TriEmbed/quercus/hardware/breakouts/README.md

# que_breakouts
Quercus project breakout board design files
## SLG46826G breakout for the TSOP-20 package part
