TriEmbed/quercus/hardware/white/esp32pinout.odt

CLK SDD CONN SD3 CMD

SD1 TDO TCK SD2

IO2 VCC 3.3V NC

IO0 GND IO5 TMS

IO4 IO16 IO23 IO34

TDI IO17 IO19 IO33

IO32 IO21 IO18 IO35

IO25 IO22 IO26 SVN

IO27 RXD SVP NC

GND TXD RST GND

CLK SDD CONN SD3 CMD

SD1 TDO TCK SD2

IO2 VCC 3.3V NC

IO0 GND IO5 TMS

IO4 IO16 IO23 IO34

TDI IO17 IO19 IO33

IO32 IO21 IO18 IO35

IO25 IO22 IO26 SVN

IO27 RXD SVP NC

GND TXD RST GND

CLK SDD CONN SD3 CMD

SD1 TDO TCK SD2

IO2 VCC 3.3V NC

IO0 GND IO5 TMS

IO4 IO16 IO23 IO34

TDI IO17 IO19 IO33

IO32 IO21 IO18 IO35

IO25 IO22 IO26 SVN

IO27 RXD SVP NC

GND TXD RST GND

CLK SDD CONN SD3 CMD

SD1 TDO TCK SD2

IO2 VCC 3.3V NC

IO0 GND IO5 TMS

IO4 IO16 IO23 IO34

TDI IO17 IO19 IO33

IO32 IO21 IO18 IO35

IO25 IO22 IO26 SVN

IO27 RXD SVP NC

GND TXD RST GND
