TriEmbed/quercus/doc/hardware/wemos/images/20220123-wemos-wrover-bottom-legend.jpg

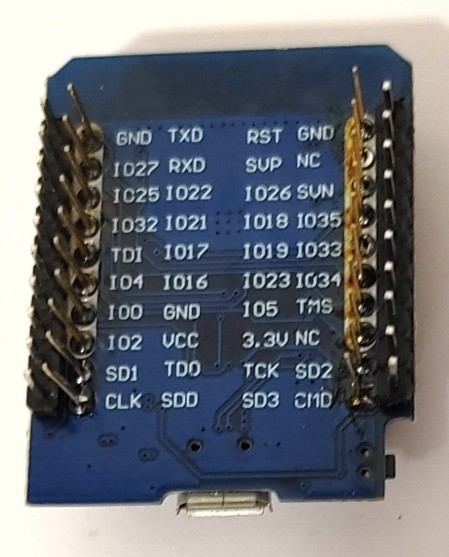
doc/hardware/wemos/images/20220123-wemos-wrover-bottom-legend.jpg
