TriEmbed/quercus/doc/hardware/wemos/images/20220123-wemos-wrover-bottom-view.jpg

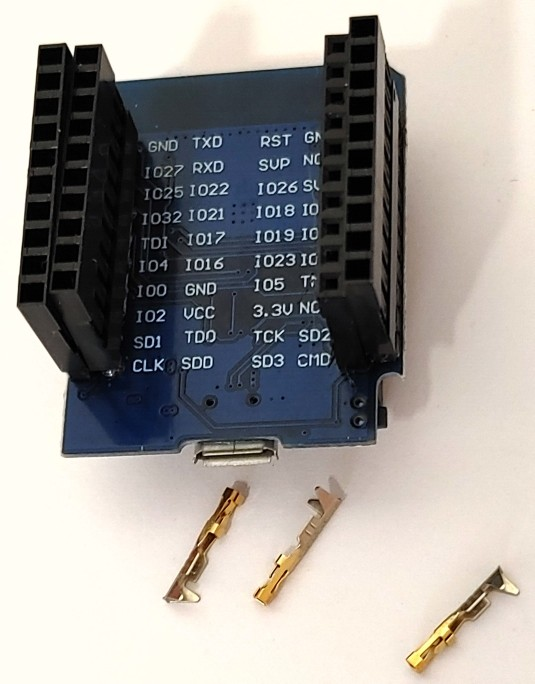
doc/hardware/wemos/images/20220123-wemos-wrover-bottom-view.jpg
