TriEmbed/quercus/doc/hardware/wemos/images/20220123-wemos-wrover-top-view.jpg

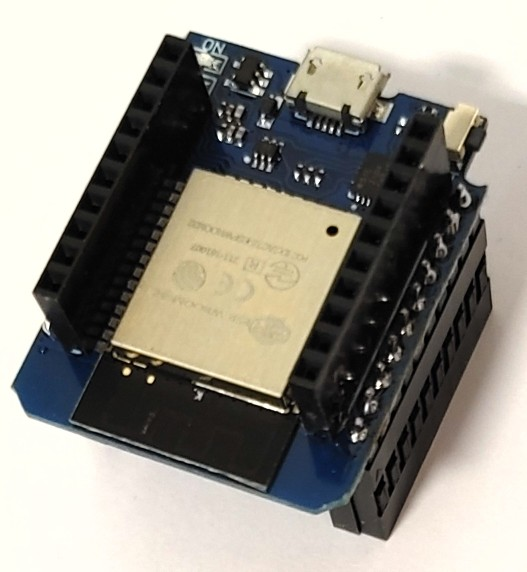
doc/hardware/wemos/images/20220123-wemos-wrover-top-view.jpg
