TriEmbed/quercus/hardware/breakouts/SLG46826G-bottom.png

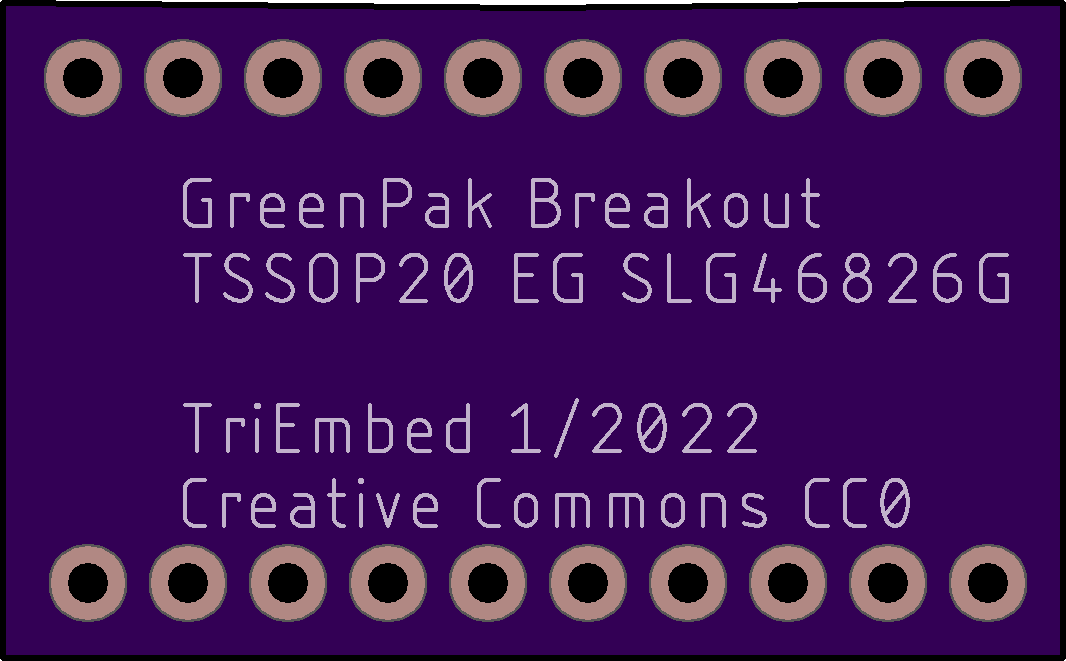
hardware/breakouts/SLG46826G-bottom.png
