TriEmbed/quercus/hardware/breakouts/SLG46826G-top.png

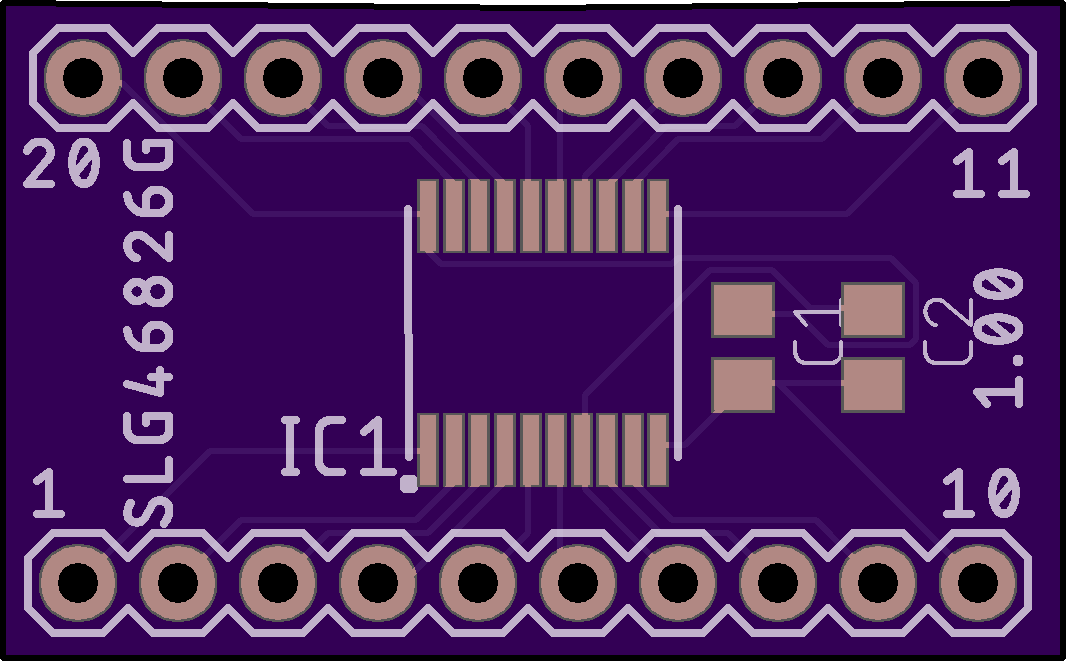
hardware/breakouts/SLG46826G-top.png
