TriEmbed/quercus/hardware/green/images/que-firedeck.jpg

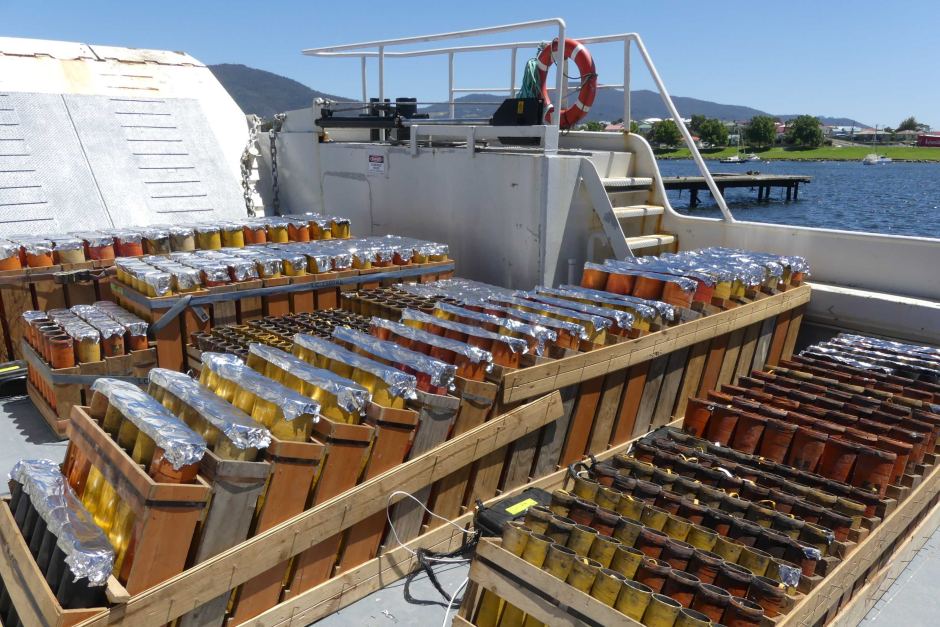
hardware/green/images/que-firedeck.jpg
