TriEmbed/quercus/hardware/purple/images/m80.png

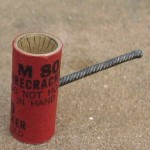
hardware/purple/images/m80.png
