TriEmbed/quercus/hardware/purple/images/model-esp32-board.jpg

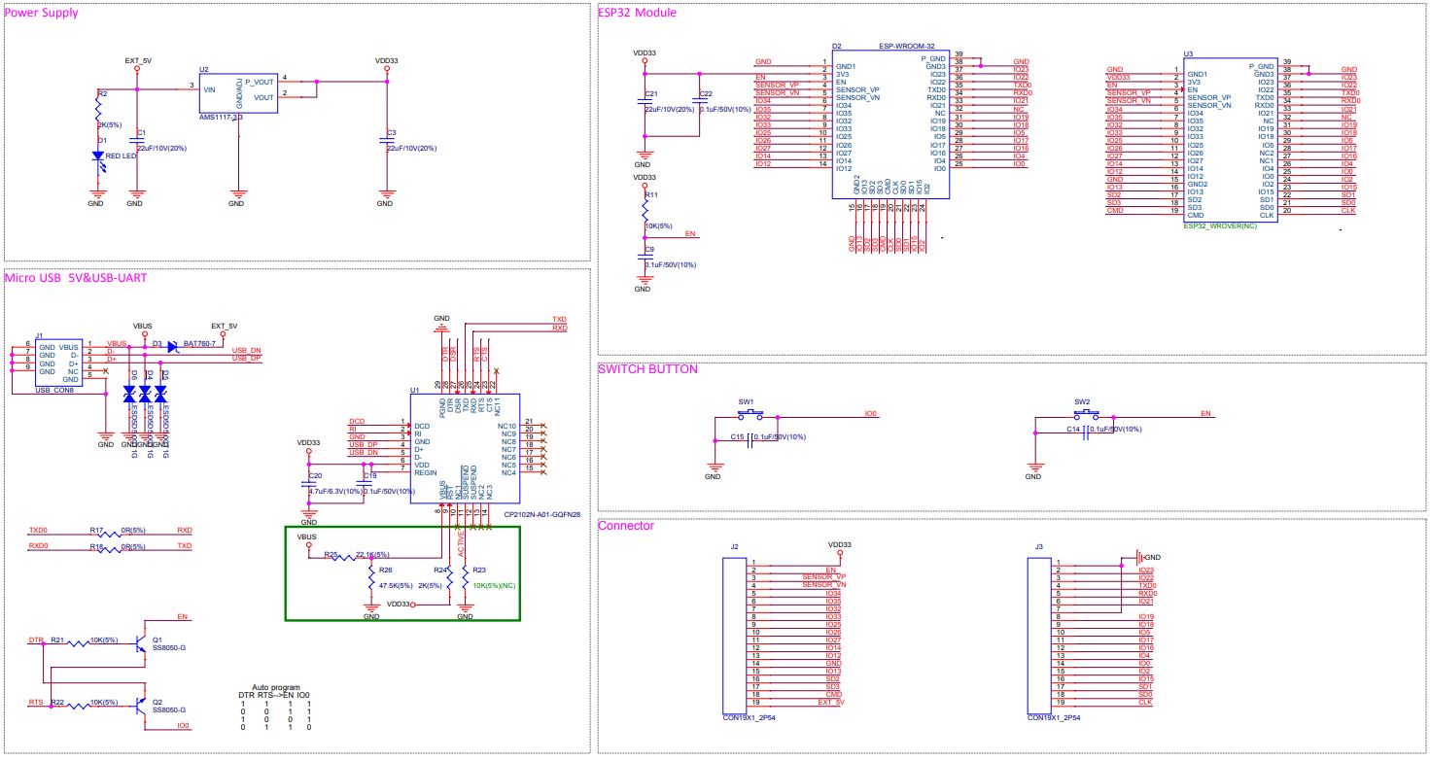
hardware/purple/images/model-esp32-board.jpg
