TriEmbed/quercus/hardware/white/board-top-view.jpg

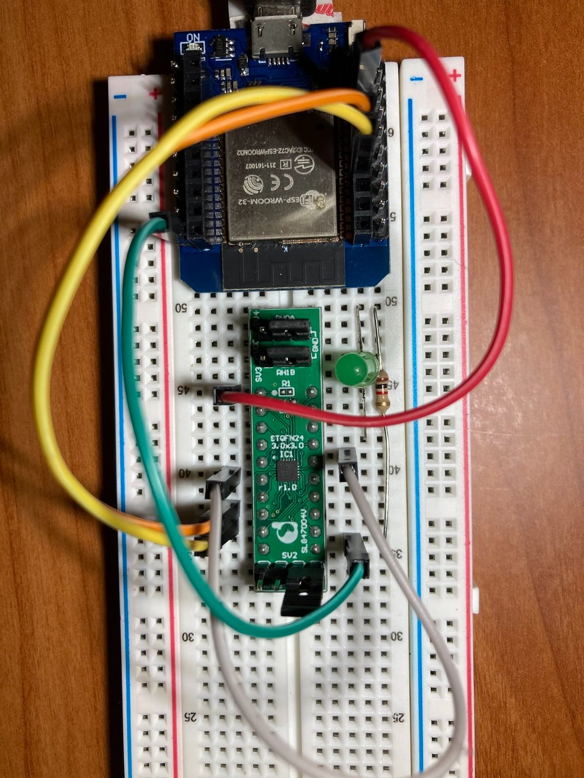
hardware/white/board-top-view.jpg
