TriEmbed/quercus/tools/aardvark-screens/image0.png

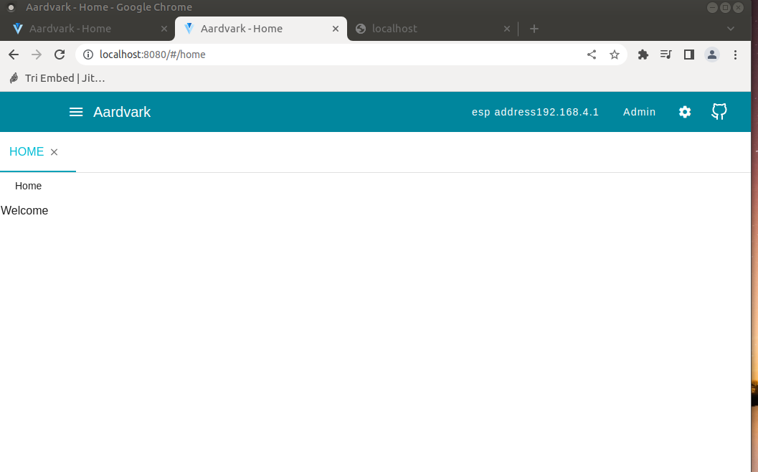
tools/aardvark-screens/image0.png
