TriEmbed/quercus/tools/aardvark-screens/image1.png

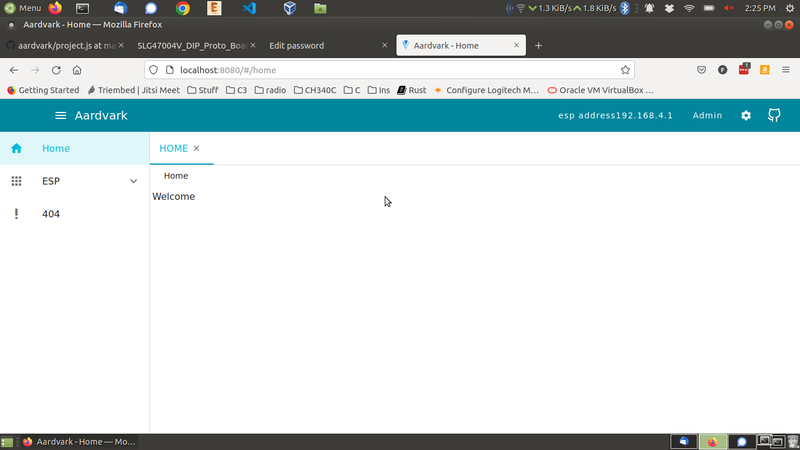
tools/aardvark-screens/image1.png
