TriEmbed/quercus/tools/aardvark-screens/image2.png

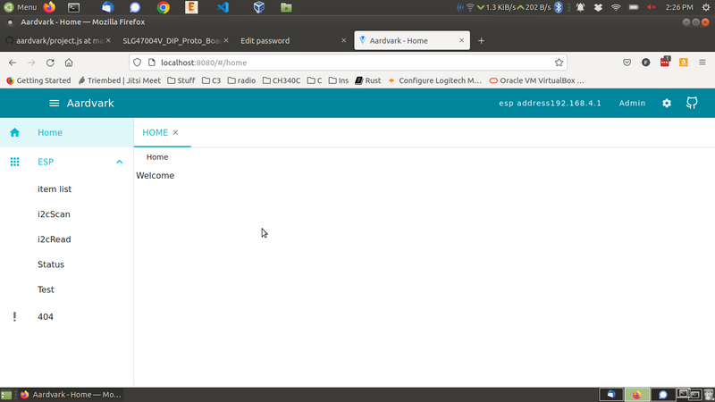
tools/aardvark-screens/image2.png
