TriEmbed/quercus/tools/aardvark-screens/image3.png

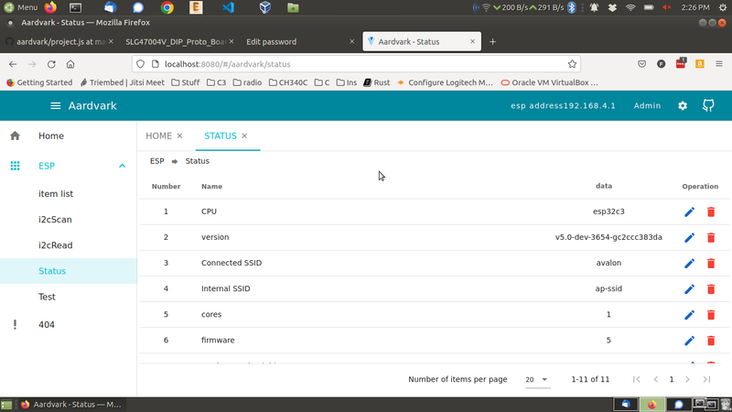
tools/aardvark-screens/image3.png
