TriEmbed/quercus/tools/aardvark-screens/image4.png

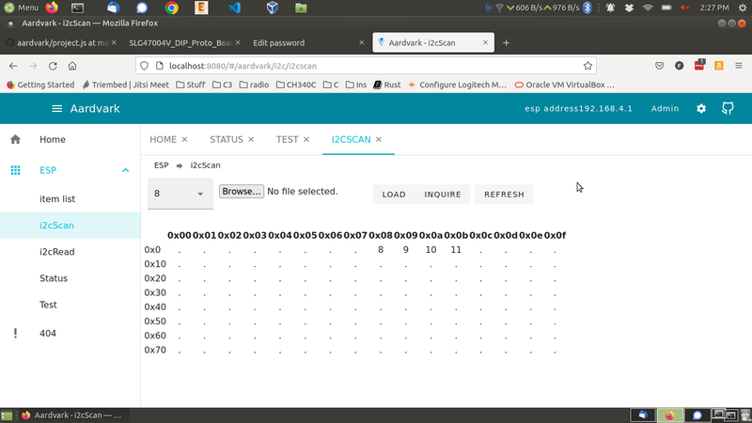
tools/aardvark-screens/image4.png
