TriEmbed/quercus/tools/aardvark-screens/image5.png

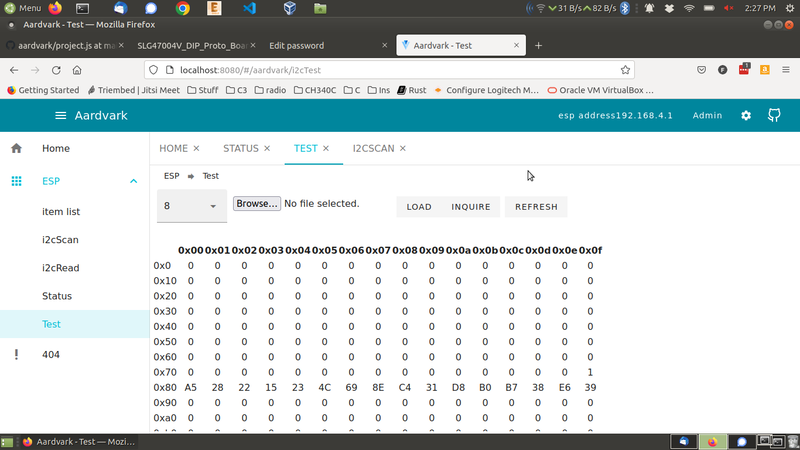
tools/aardvark-screens/image5.png
