TriEmbed/quercus/hardware/purple/doc/INVENTORY.md

# TriEmbed Community Project Material Inventory

## @ Edgington Labs (Nick Edgington)
1. 100 OTP Dialog chips + one special SMD programming socket
2. ESP32 and ESP C3 modules, breakouts, related resources
3. 2 SLG47004V-DIP breakouts
4. 2 SLG46826G breakouts
5. 10 LM1117 3.3 v regulator chips
6. N MINI USB sockets for prototype board
7. One version 0.70 m80 board
    1. 4.7uF cap from EN to ground to stretch resets
    2. Pullup/SPST combos on EN, GPIO8 and GPIO9 to set boot state
8. Several "plexiglas ESP32C3 module carrier boards"

## @ Apex Proto Factory (Pete Soper)
1. One version 0.60 m80 board
2. One version 0.70 m80 board
3. 6 SLG46826G chips
4. 10 SLG46824G chips
5. 10 SLG46620G chips
6. 17 SLG47004V-DIP breakouts
7. Approx 40 SLG47004V-DIP breakouts
8. 15 TSSOP20/SOIC20 Adafruit breakout boards for above 3 TSSOP package chips
9. ESP32 related resources
11. 12 LM1117 3.3 v regulator chips
12. 43 mini USB sockets suitable for SMT
13. 15 ES32C3 modules

## @ Paul MacDougal
1. More USB mini sockets to barter for stuff

## @ Jaimie Johnsen
1. One version 0.70 m80 board
2. One SLG47004V-DIP

## @ Rob Mackie
1. One 0.60 m80 board
2. One SLG47004V-DIP
