TriEmbed/quercus/hardware/purple/eagle/v0.70/BOM.ods

MF Part #` | Vendor # | Vendor | Description | quantity
USB2066-05-RBHM-15-STB-00-00-A | 640-2665RBHM15STB00A | Mouser | Mini USB socket | 1
CH340C |  | Ebay | USB interface chip with RTS, DTR control | 1
LM1117MPX-3.3/NOPB | LM1117MPX-3.3/NOPBCT-ND | Digikey | 3.3V, 800mA linear regulator SOT223-4 package | 1
 |  | Pete | 0805 10uF ceramic capacitor | 1
 |  | Pete | 0805 4.7uF ceramic capacitor | 1
 |  | Pete | 0805 510 ohm resistor | 2
 |  | Pete | 0805 yellow LED | 1
 |  | Pete | 0805 blue LED | 1
 |  | Digikey | 100uF aluminum electrolytic capacitor | 1
ESP32-C3-M01 |  | Ebay | AI Thinker ESP32-C3-M1 module 4MB flash | 1
TS09-63-25-R-160-SMT-TR | 179-TS09625R160SMTTR | Mouser | SPST momentary contact switch – red | 1
TS09-63-25-WT-160-SMT-TR | 179-TS0925WT160SMTTR | Mouser | SPST momentary contact switch – white | 1
JS202011SCQN | 611-JS202011SCQN | Mouser | SPDT slide switch | 1
 |  | Pete | nine position right angle male header | 2
 |  | Pete | 10 position long pin female header | 4
 |  | Pete | four position right angle male header | 1
Last updated 7/22/2022
