TriEmbed/quercus/doc/presentations/20220831-InstallSteps.odp

## Quercus Installation/startup in pictures 8/31/2022

The following slides show a shell session during the build, install and startup steps for the Quercus software and firmware and the browser view of the Aardvark software running.

## Slide 2

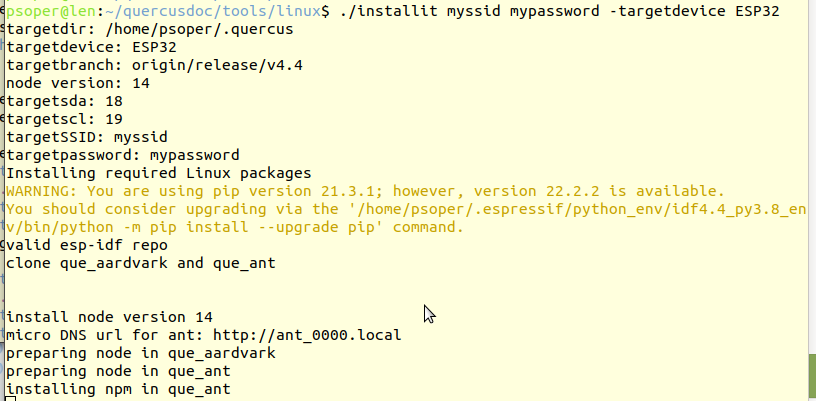
[picture p21: figure]

## Slide 3

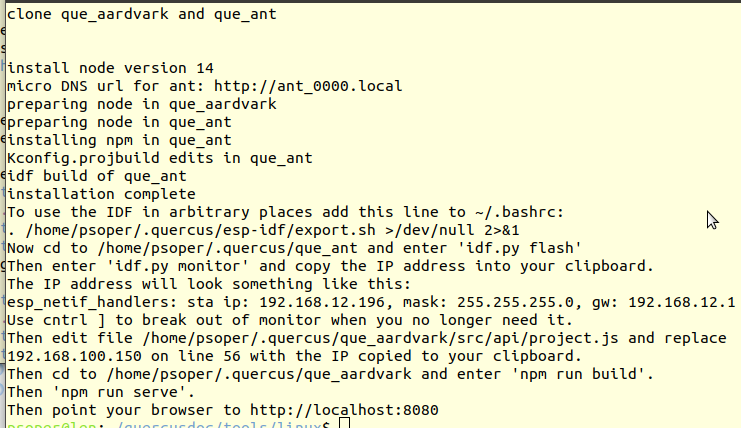
[picture p22: figure]

## Slide 4

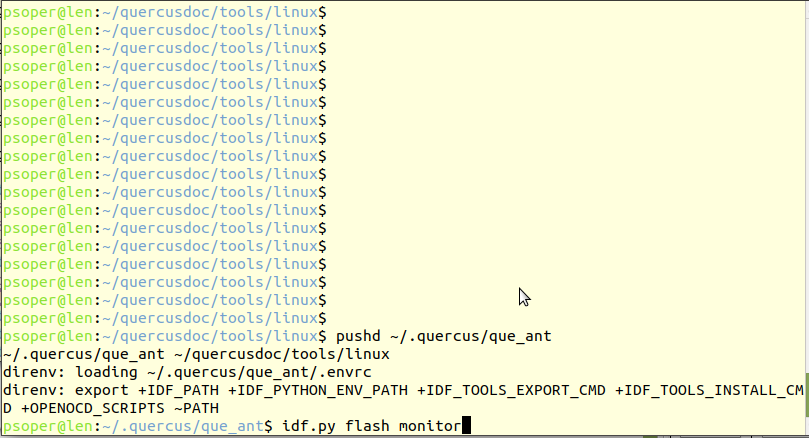
[picture p23: figure]

## Slide 5

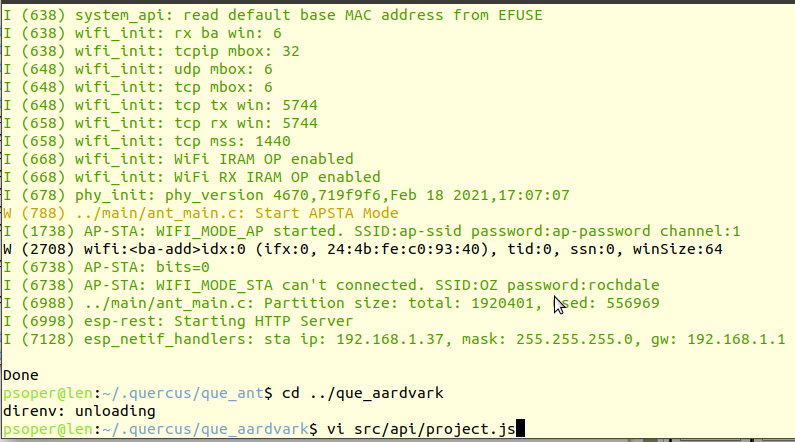
[picture p24: figure]

## Slide 6

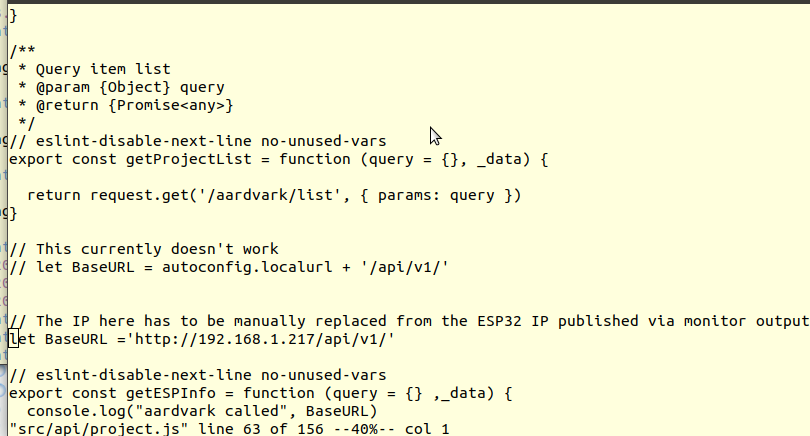
[picture p25: figure]

## Slide 7

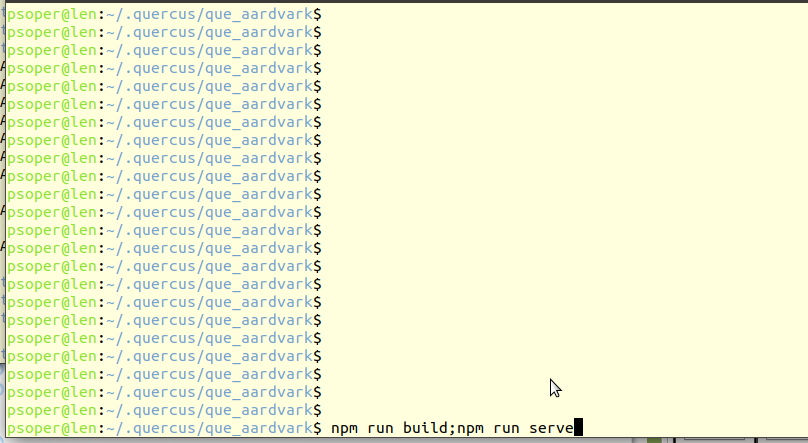
[picture p26: figure]

## Slide 8

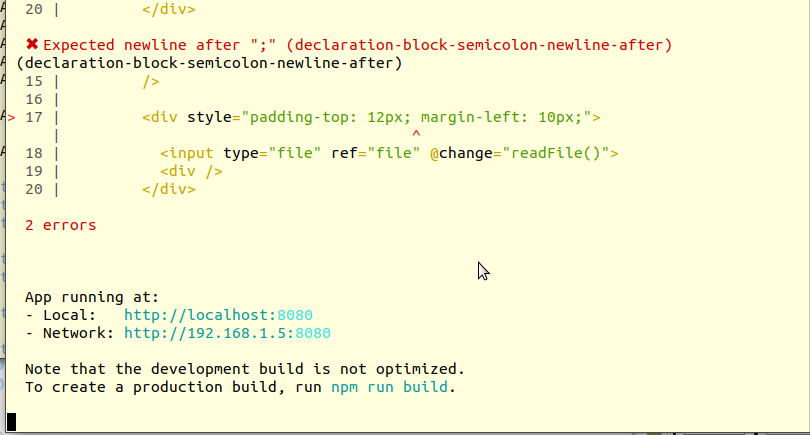
[picture p27: figure]

## Slide 9

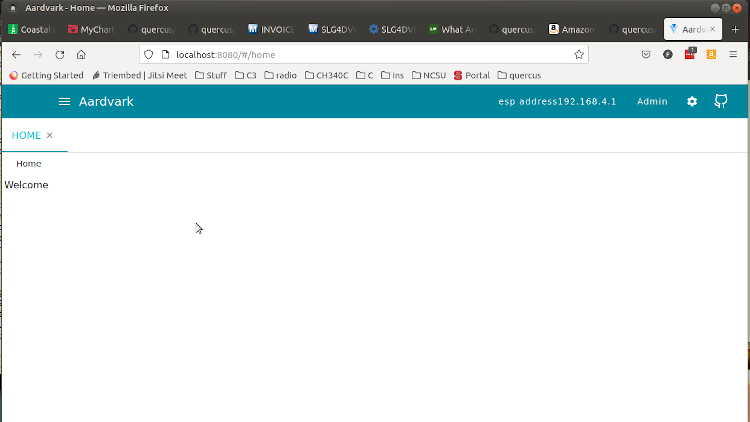
[picture p28: figure]

## Slide 10

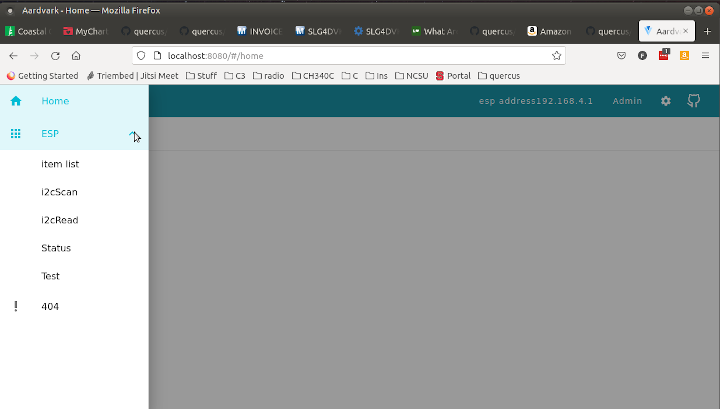
[picture p29: figure]

## Slide 11

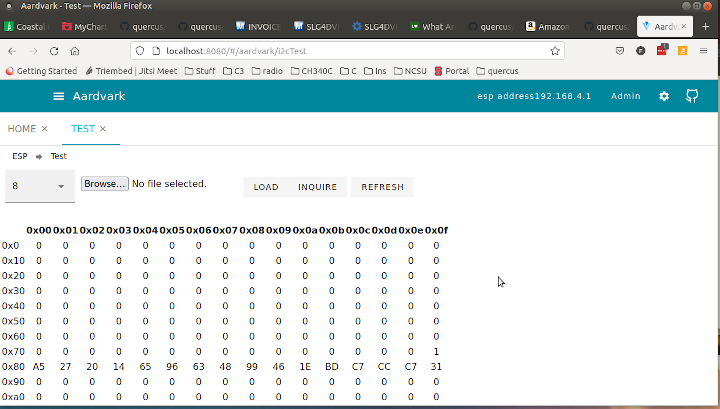
[picture p30: figure]

## Slide 12

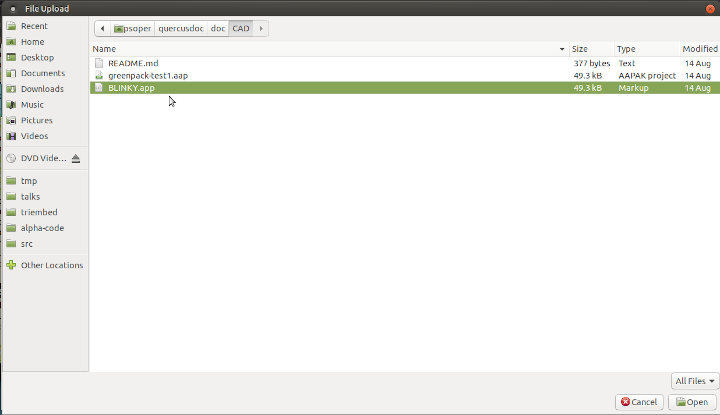
[picture p31: figure]

## Slide 13

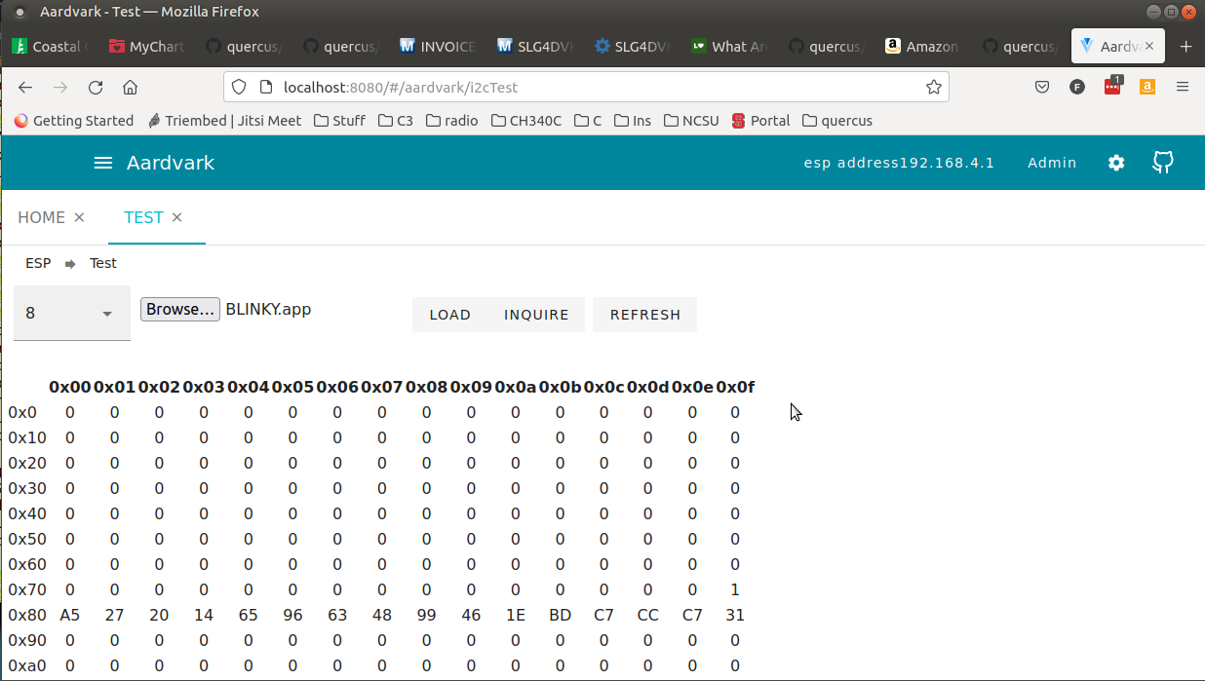
[picture p32: figure]
