TriEmbed/quercus/tests/README.md

# que_tests
This is the testing kick-off point for the rest of the Quercus project.
