TriEmbed/quercus/(threads)

Thread 16 (2022-07-18):

Change reset and boot switches

petesoper, 2022-07-18:
Alternative, SPST switches must be substituted as a SPST flavor is not available for the current part.

petesoper, 2022-08-04:
In hand, but need new Eagle footprint.

Thread 5 (2022-07-18):

Consider making esp-idf clone/prep separate from -targetdir dirs

petesoper, 2022-07-18:
It would probably be better to make the cloning/prep of the Espressif IDF treated as a "one time" operation with a separate default and targeted directory with the default being $HOME. It is a frequent source of confusion and problems to believe that a "collection" of esp-idf clones in different directories are actually available. The truth is that the clone where install.sh was executed most recently is "it" and export.sh does NOT implicitly repeat install.sh actions.

The proposal is to have installit recognize option switch "-targetidfdir" (that begs the question of whether underscores should be used in the option names!). This would correspond to internal variable targetidfdir that would default to $HOME (aka ~) and that directory would could esp-idf. The expectation is that 99% of the time almost all users will clone esp-idf exactly once until/unless the stable version changes (a few of the developers being the exception).

This change will allow for easy creation of multiple target directories for customized que_ant (and possibly que_aardvark) repos while avoiding the large disk space penalty of redundant IDF clones. Also, it should be pointed out that the expectation is that soon there will be a convention for having user-defined code to provide "applications" for que_ant instances as the ESP32 is engaged to do more than just program an FPGA. This use case will tend to drive the generation of case-specific collections of the two repos.

Closed 2022-08-04.

Thread 7 (2022-07-18):

Tools: 7/18/22 installit change bundle

petesoper, 2022-07-18:
This is to document the set of changes to the Quercus tool chain file que_tools/linux/installit described below. The git change log for que_tools will have commit messages referencing this issue.

1. Determine if the user is in the dialout group and if not add them with instructions for the need to log out/login in for the change to take effect. This will happen before Linux package installs and a prompt for a sudo password will be emitted as needed.
2. File $targetdir/que_aardvark/src/autoconfiguration.js contents will be changed to define a single domain name que_ant0000.local for use by MDNS. After other changes and testing this change will enable installit to be a complete solution that avoids the need for manual steps currently described by echos near the end of the script.
3. The execution of esp-idf/install.sh will *always* take place to ensure that the right Espressif IDF is used in cases where an install has been done outside the context of the installit script. NOTE WELL that install.sh hard wires a set of files in $HOME/.expressif and all subsequent actions enabled by sourcing export.sh will use these tools. So no matter how many clones of the esp-idf repo there are, only the most recent one within which install.sh is executed is relevant as export.sh simply enables the environment to access the files in $HOME/.expressif.
4. There is still an issue with direnv working properly for "first time users" because of a wrongly placed source of .bashrc
5. Accept lower or upper case target device names, e.g. esp32 as well as ESP32.
6. Have the sed changes to que_ant/main/Kconfig.projbuild and que_ant/components/apsta/Kconfig.projbuild key off patterns in inline comments following the parts of the line to be changed. This will eventually allow for avoidance of redundant cloning and preparation of que_ant and que_aardvark. This change must be coordinated with edits of the above to files that are documented in que_ant issue TriEmbed/quercus#7.
7. The esp-idf git branch handling is broken. To determine the current branch a "git branch -a" should be piped into a grep of '\*' and comparison with $targetbranch, taking into account that the default branch shown with -a is missing the prefix "remotes/". The default value of targetbranch should be set in the repo with "git branch $targetbranch".

petesoper, 2022-08-12:
Reviewed by @dtrembath. Found one unrelated bug in command line handling (lack of first and second command line argument not flagged as error, issue to be filed).
Commit 245524f4405e2c1ad35034e703eabe5bfd94fe1a

Closed 2022-08-12.

Thread 13 (2022-07-19):

Support for application code

petesoper, 2022-07-19:

petesoper, 2022-09-17:
I drastically simplified this issue.

petesoper, 2022-09-17:
Here is psuedocode for supporting user code:
<spawn thread and in that thread:>
setup();
while (true) {
  loop();
  yield();
}
(As stated elsewhere power optimization is differed)

petesoper, 2022-09-17:
The tricky bit might be the weak links for setup and loop.

petesoper, 2022-09-17:
OK, ignore all but the first comment.

Thread 21 (2022-07-25):

Network-centric operation of Quercus

petesoper, 2022-07-25:
(Submitted for Nick Edgington, the author of the proposal)

This is a medium to long range enhancement proposal, not something that will be just around the corner if approved. As a priority it would come after exploiting MDNS to eliminate manual install operations and would involve considerable development.

This proposal replaces the WIFI/USB hybrid mix of communication with a purely WIFI interface to the Quercus dev boards running que_ant firmware. It also includes a number of powerful features including zero-installation access to the que_aardvark application and the ability to update the dev board firmware over the air.

Currently the flow for use of a dev board is as follows:
1. User uses the "installit" script to set up tool chain components
2. User uses temporary steps to flash and prepare the que_aardvark code (soon to be replaced by MDNS use)
3. User uses a web browser to run que_aardvark and uses it to program the FPGA(s) following steps in the Quercus user manual
4. User makes use of some means TBD to include their own application code to the que_ant base layer (see que_ant issue TriEmbed/quercus#20 proposal)

This enhancement provides a new flow:

1. User reads MAC address engraved on board and URL to instructions at https://TriEmbed.org/tbd
2. User plugs in dev board to supply power to it
3. User changes their SSID to "que_ant" and the password from the board or instructions (TBD)
4. User points browser to the dev board URL (from instructions)
5. User sees hyperlinks on the browser screen to set the board to the user's local SSID and password
6. User switches their computer back to their local SSID
7. User points browser to ant_nnnn.local, where nnnn is normally the last digits of the MAC address on the bottom of the dev board (but can also be to some other dev board previously put on the network).
8. User will see the TriEmbed server hyperlink and take the browser to that page.
9. User will then have Aardvark running on their browser and this will support programming FPGAs with steps similar to the current ones.
10. Additional web controls will allow downloading Aaardvark and ant source code as archives and uploading and flashing via OTA new Ant+user app images built using the Espressif IDF.

Thread 19 (2022-07-26):

Time to make a project plan

petesoper, 2022-07-26:
It's time to circle back and tackle the questions asked at the first couple of project meetings. Who are our users and what are their requirements? Priorities? Steps needed to develop while holding to many small changes and refinements vs "the whole thing, fully formed will be inflicted on the world on date X"? So far the project has been financed by three benefactors. If we scale up as some of us expect to (Macrofab or the like, here we come: Pete will only make the next 12-15 boards (help welcomed) and after that a maximum of three of any specific design). How do we handle selling things? Do we need to ask a local nonprofit for help doing this to avoid regulatory/legal snarls? A basic part of the project plan is to map the work to the people involved. If the plan calls for more people's time than we can reasonably expect to have, the plan must be changed. But by not having a plan we can comfortably imagine that resources are no issue.

Thread 3 (2022-07-28):

tools:git build subsystems into the drop down for issues

RobMackie, 2022-07-28:
We want issues to track their substystems. we want to add it to the intial drop down. and train people to use it. (if we can)

Thread 23 (2022-08-04):

hardware/purple: Specifications for 1.00 board (EVERYBODY needs to review this, please!)

petesoper, 2022-08-04:
Prerequisites:
1. Finish testing SMD adapter and I2C bus extender.
2. Breadboard boot and reset circuits and confirm RC timing
3. Confirm interconnect between SMD adapter header sockets, DIP sockets and outboard male headers
Changes:
1. New switches: Black for boot, Red for reset
2. RC changes as needed
3. Revisit pin choice for user-programmable LED.
4. Consider slide switch to isolate LED circuit so pin available for other applications
5. Must have better silk screen. Critical to make it possible to determine the numbering of the 20 pins of the DIP/SMD adapter
6. Consider LONG male headers making it practical to use the board without a solderless breadboard. Leave pins off a few boards to allow choice, but those being distributed should be consistent.
7. REALLY should switch to micro-USB connector.
8. What else??

petesoper, 2022-08-04:
Prerequisite:
4. Name change
Changes:
9. Better bottom silk screen (e.g. URL of repo)
10. Engraved MAC address on top of board (silk screen high order digits?)

Thread 28 (2022-08-19):

Linux tool installation updates

petesoper, 2022-08-19:
1. Add top level linux_install.sh that invokes tools/linux/installit
2. Fix bug where the install command with no arguments is not flagged with an error
3. Update installation how-to to reflect the unified repo, top level script and anything else that does not reflect the current state of things. NOTE that there is a flaky bug in aardvark that causes startup operation to be random:
    1. Sometimes there is a "login" dialog box, but it has defaults in place and the user can easily get past it. This is relatively rare.
    2. Sometimes the left side set of buttons/menus does not appear until three horizontal bars selected and drop down picked
    3. Messages that are put out by install script as it is completing no longer match (if they are even mentioned) and some of them are now conditional (e.g. only see instructions for logging out of user session and back in if had to be added to dialup group).

cnobile2012, 2022-08-22:
Pete, I can work on this issue if you want. I already started it before I noticed you had assigned it.
I'll contact you when and if I need help understanding something.

petesoper, 2022-08-23:
Actually Dawn has taken over the Linux installer and was already assigned. But there's lots more left to tackle.
Pete

Aug 22, 2022 7:53:05 PM Carl J. Nobile ***@***.***>:

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

Thread 29 (2022-08-20):

hardware/white docs

petesoper, 2022-08-20:
Need enough docs to reproduce the white board.
1. hardware/white/README.md has the main doc
2. hardware/esp32pinout.odt has top view pinout diagram of the ESP32 board
3. need decent top view photograph
4. need text list of pin connections

Thread 32 (2022-08-23):

Create Bug Report issue template

FrugalGuy, 2022-08-23:
Please look at the Bug Report issue template.
I hope it sparks ideas for what information you need to have to triage and respond to bug reports.
What do you like or not like?
What would you prefer I remove or add?

FrugalGuy, 2022-08-27:
From @petesoper:

> So hanging off "bug report" I recommend we start simple and use the last five boxes (what is expected behavior through more information) and in addition to that have the "what is your hardware?" and "what is your OS?". The hardware text box could name Quercus purple (version 0.60 or 0.70?), Quercus white, custom with _______ dev board. Initially all of us but Carl are using the same old little ESP32 board (with a 300ma regulator, by the way: live and learn) or one of the quercus dev boards that are Osh Park purple. This would naturally get expanded or maybe it could have drop downs or something at the point where folks start getting involved with more random hardware.

> But the hardware needs one more detail at least and that's what FPGA(s) are in use. All of us are using the SLG47004V-DIP, but this will change, we'll start having multiple FPGAs hanging off a single ESP32, etc. And further down the road when some of Nick's futures come out of the pipeline there may have to be much more detailed questions about peripherals and other stuff attached to the ESP32, etc.

FrugalGuy, 2022-08-27:
@petesoper , terrific feedback, thanks!
I'll get on that today.

Thread 37 (2022-08-27):

Create helpful links on New Issue page

FrugalGuy, 2022-08-27:
We can customize the New Issues page.
Some teams add helpful links here to possibly head off new issues that could be answered by referring to other sources of information.

These can link to anything we like.  Pages on our own repo, forums, web sites, whatever.

I'm putting some **starter samples** there, taken from another ESP32 project on github.

- What links do we think might be useful here?

FrugalGuy, 2022-08-27:
From @petesoper

> OK, about the stuff hanging off "new issue". Are the two boxes about "Gitter channel" and arduino in the right place here? That is, doesn't it seem to imply that somebody could go to the forum and find some bread crumb about quercus? Maybe these resources would be better hanging off the top level [README.md](http://readme.md/)? Just throwing this out there.

FrugalGuy, 2022-08-27:
The point is to have a "last minute" reminder of useful links for folks about to open a new ticket.

So, yeah, one of the links should be back to the README.md or anything else you think might be useful to somebody who is clearly thinking of opening a ticket.

IOW, it's not an either/or, but rather an **that/and**.

I'll add a link to the README.md.

❓ What resources do you recommend, @petesoper?  Remember, the ones there now are just placeholders I grabbed from another project -- unlikely to be a perfect match by accident.  :-)

petesoper, 2022-08-27:
We should at least have an FAQ link. Mora thought needed.
Pete

Aug 27, 2022 11:31:44 AM Ron Craig ***@***.***>:

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
