TriEmbed/quercus/hardware/purple/eagle/v0.50/m80-v0.50-sch.pdf

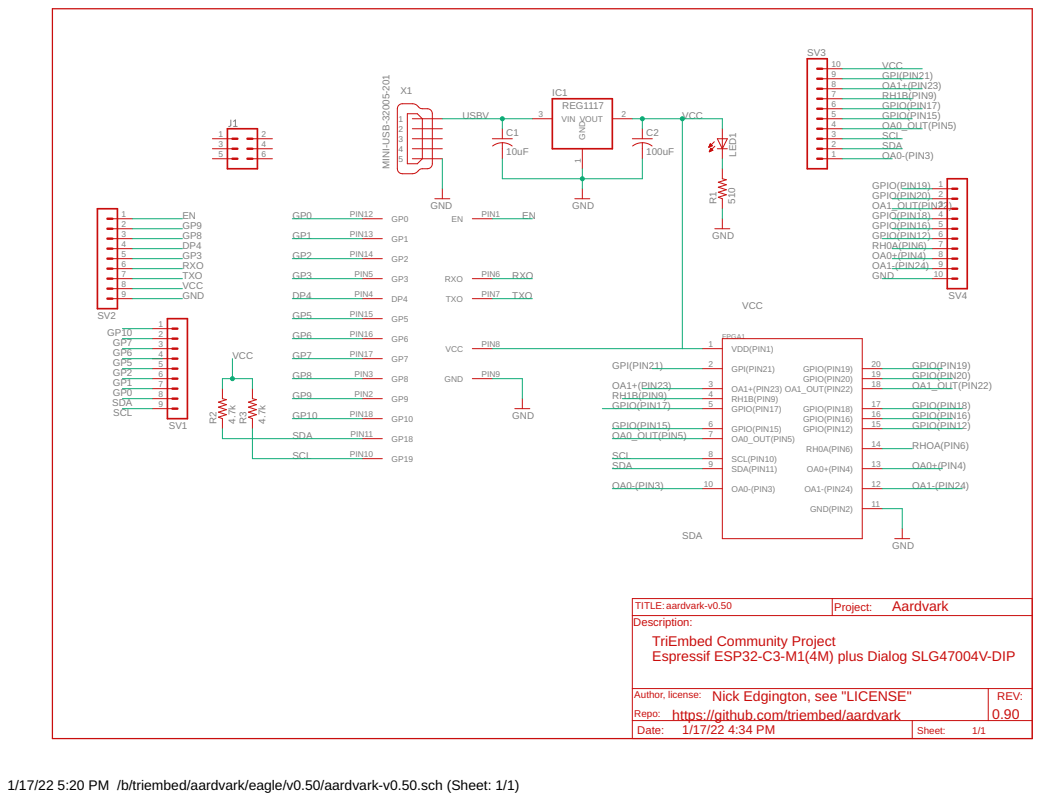
[picture p33: page 1]

TriEmbed Community Project
Espressif ESP32-C3-M1(4M) plus Dialog SLG47004V-DIP

Nick Edgington, see "LICENSE" https://github.com/triembed/aardvark

1/17/22 5:20 PM /b/triembed/aardvark/eagle/v0.50/aardvark-v0.50.sch (Sheet: 1/1)
