TriEmbed/quercus/hardware/purple/eagle/v0.60/m80-v0.60-sch.pdf

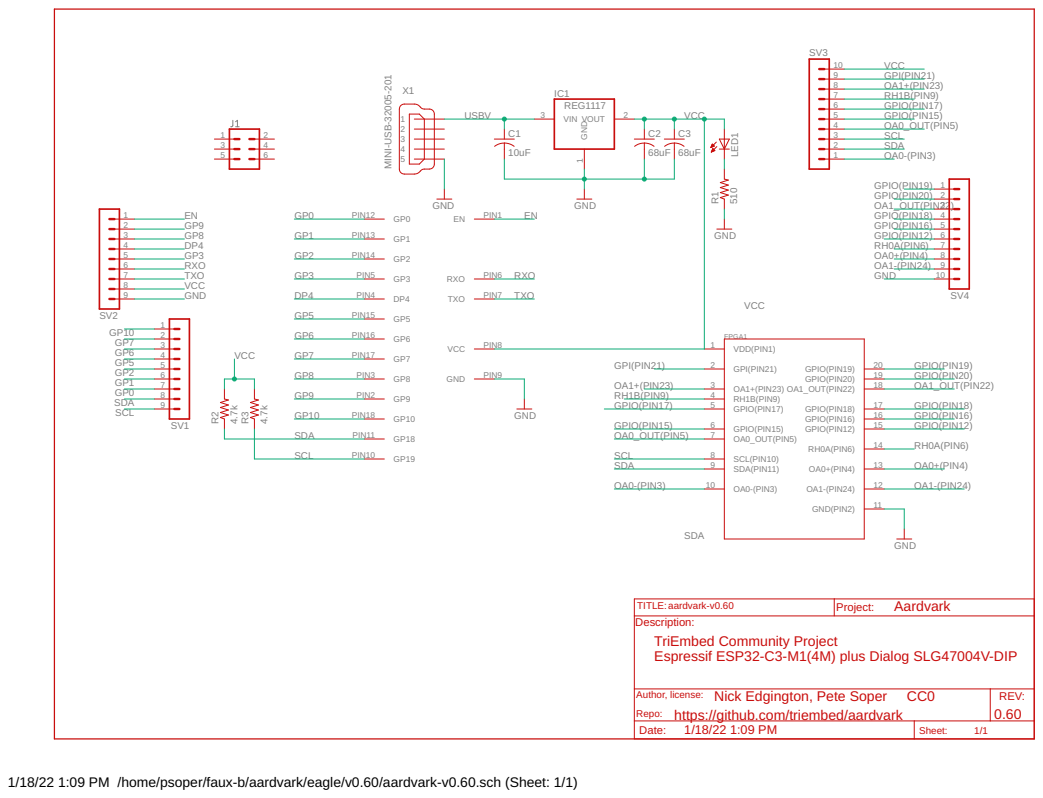
[picture p34: page 1]

TriEmbed Community Project
Espressif ESP32-C3-M1(4M) plus Dialog SLG47004V-DIP

https://github.com/triembed/aardvark

1/18/22 1:09 PM /home/psoper/faux-b/aardvark/eagle/v0.60/aardvark-v0.60.sch (Sheet: 1/1)
