TriEmbed/quercus/hardware/purple/eagle/v0.65/m80-v0.65-schematic.pdf

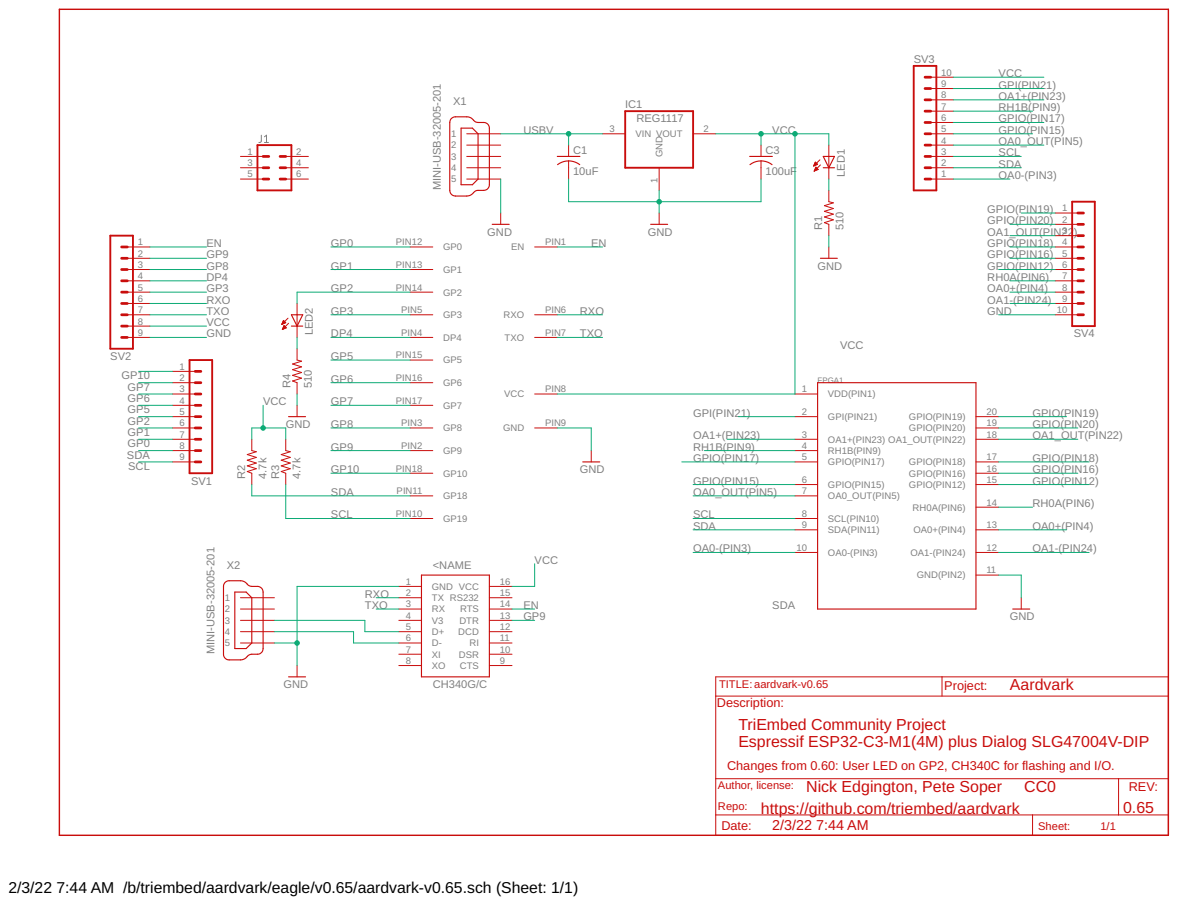
[picture p35: page 1]

TriEmbed Community Project
Espressif ESP32-C3-M1(4M) plus Dialog SLG47004V-DIP
Author, license:
https://github.com/triembed/aardvark

2/3/22 7:44 AM /b/triembed/aardvark/eagle/v0.65/aardvark-v0.65.sch (Sheet: 1/1)
