TriEmbed/quercus/hardware/purple/eagle/v0.70/m80-v0.70-schematic.pdf

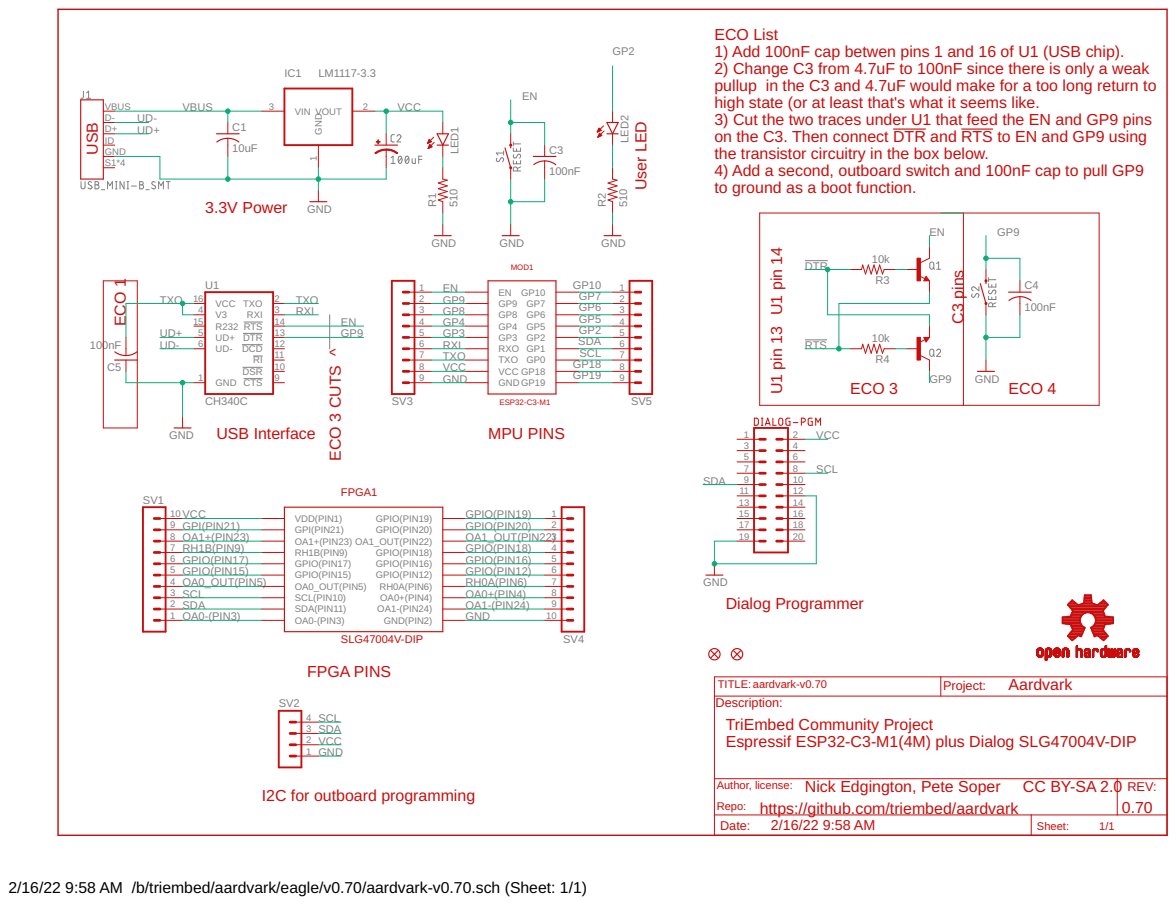
[picture p36: page 1]

ECO List
1) Add 100nF cap betwen pins 1 and 16 of U1 (USB chip). 2) Change C3 from 4.7uF to 100nF since there is only a weak
pullup in the C3 and 4.7uF would make for a too long return to
high state (or at least that's what it seems like. 3) Cut the two traces under U1 that feed the EN and GP9 pins
on the C3. Then connect DTR and RTS to EN and GP9 using
the transistor circuitry in the box below. 4) Add a second, outboard switch and 100nF cap to pull GP9
to ground as a boot function.

OA1+(PIN23) RH1B(PIN9) GPIO(PIN17) GPIO(PIN15) OA0_OUT(PIN5) SCL(PIN10) SDA(PIN11)

TriEmbed Community Project
Espressif ESP32-C3-M1(4M) plus Dialog SLG47004V-DIP

https://github.com/triembed/aardvark

2/16/22 9:58 AM /b/triembed/aardvark/eagle/v0.70/aardvark-v0.70.sch (Sheet: 1/1)
