TriEmbed/quercus/hardware/purple/eagle/v0.50/m80-v0.50-brd.pdf

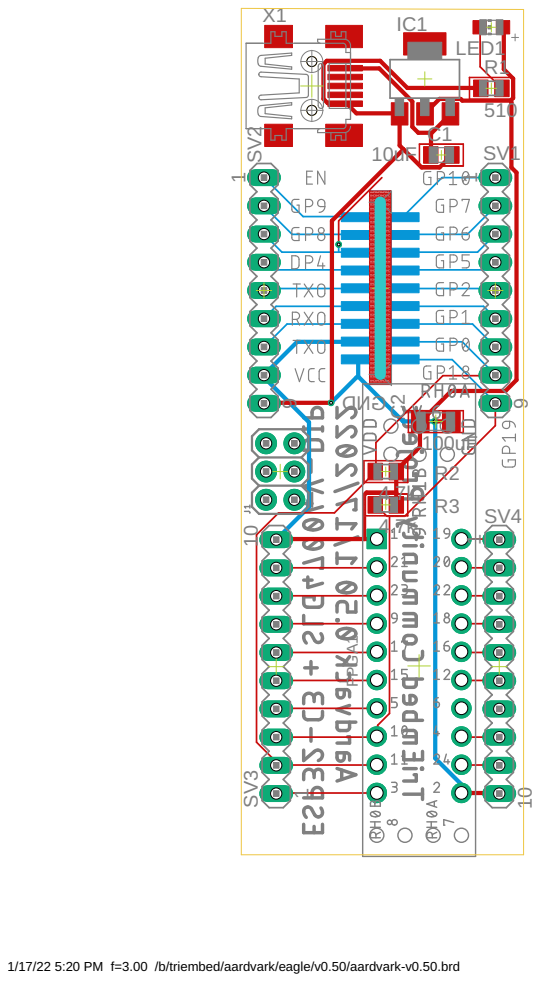
[picture p38: page 1]

1/17/22 5:20 PM f=3.00 /b/triembed/aardvark/eagle/v0.50/aardvark-v0.50.brd
