TriEmbed/quercus/hardware/purple/eagle/v0.70/m80-v0.70-board.pdf

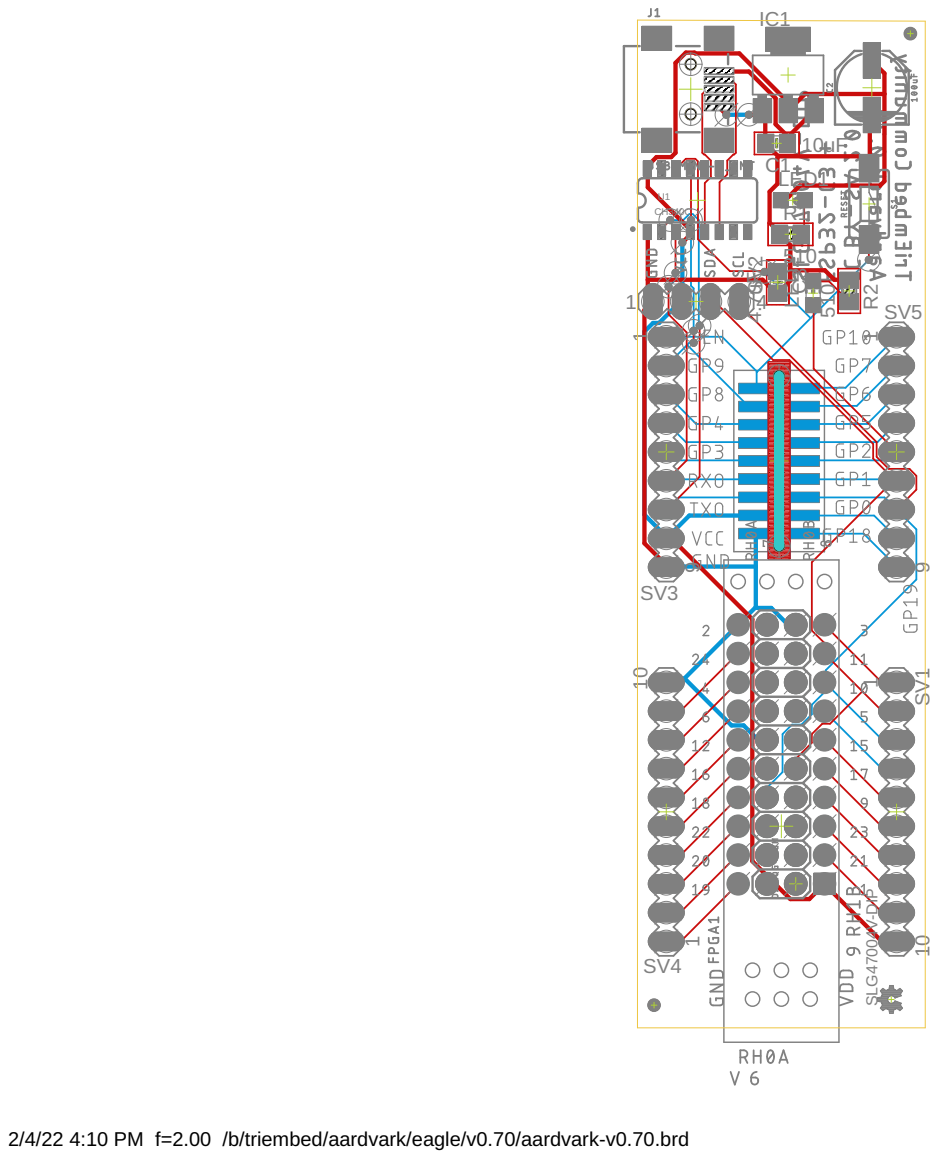
[picture p39: page 1]

2/4/22 4:10 PM f=2.00 /b/triembed/aardvark/eagle/v0.70/aardvark-v0.70.brd
