TriEmbed/quercus/hardware/purple/eagle/v0.80/m80-v0.80-layout.pdf

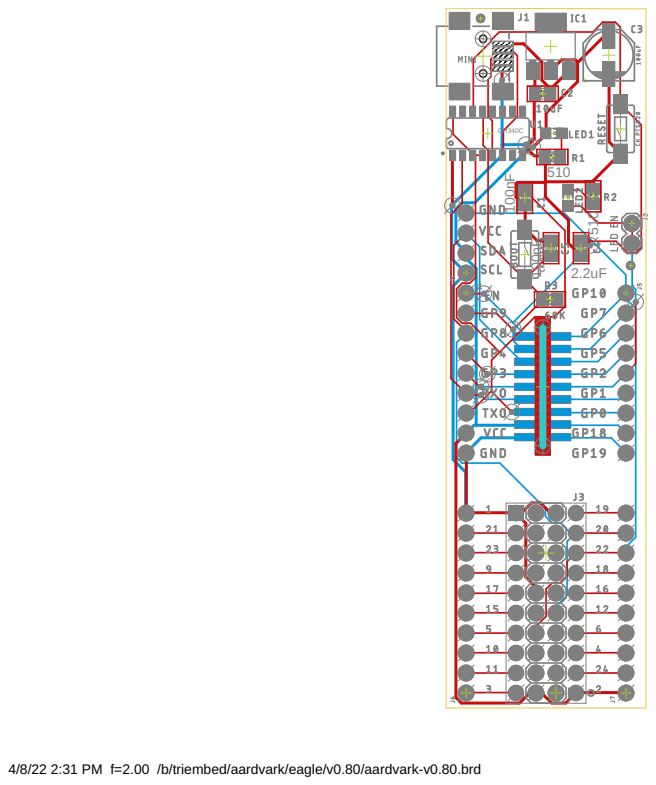
[picture p40: page 1]

4/8/22 2:31 PM f=2.00 /b/triembed/aardvark/eagle/v0.80/aardvark-v0.80.brd
