TriEmbed/quercus/hardware/purple/eagle/v1.00/purple-v0.80.brd

## EAGLE design hardware/purple/eagle/v1.00/purple-v0.80.brd (2022-08-02)

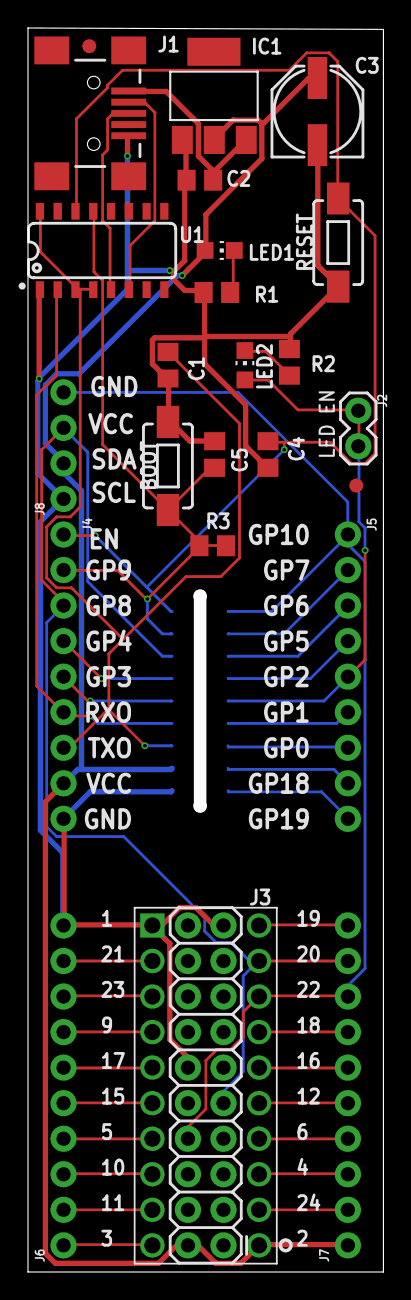
[picture p41: board purple-v0.80.brd from above]

Board: 2 copper layers, 25.4 x 88.9 mm, 27 parts (1 on the bottom side), 39 nets.

Parts:
BOOT: CK PTS820; TACTILE_SWITCH_SMD_6.0X3.5MM
C1, C5: 100nF; C0805
C2: 10uF 399-6674-1-ND; C0805
C3: 100uF; PANASONIC_D
C4: 2.2uF; C0805
FD1, FD2: FIDUCIAL1X2; FIDUCIAL-1X2
IC1: LM1117-3.3; SOT223
J1: MINI; USB-MINIB
J2: 1X02
J3: 2X10
J4, J5: 1X09_NO_SILK
J6, J7: 1X10_NO_SILK
J8: 1X04_NO_SILK
LED1, LED2: CHIP-LED0805
LOGO1: OSHW-LOGOMINI; OSHW-LOGO-MINI
MOD1: ESP32-C3-M1; AITHINKER-C3-M1
MOD2: SLG47004V-DIP
R1, R2: 510; R0805
R3: 68K; R0805
RESET: CK PTS820; TACTILE_SWITCH_SMD_6.0X3.5MM
U1: CH340C; SO016

Connections:
EN: C4.2, J4.1, MOD1.PIN1, RESET.2, U1.14
GND: BOOT.1, C1.1, C2.2, C3.-, C4.1, C5.1, IC1.1, J1.GND, J3.12, J3.19, J4.9, J6.10, J8.1, MOD1.PIN9, MOD2.1, R1.1, R2.1, RESET.1, U1.1
GP0: J5.7, MOD1.PIN12
GP1: J5.6, MOD1.PIN13
GP2: J2.1, J2.2, J5.5, LED2.A, MOD1.PIN14
GP3: J4.5, MOD1.PIN5
GP4: J4.4, MOD1.PIN4
GP5: J5.4, MOD1.PIN15
GP6: J5.3, MOD1.PIN16
GP7: J5.2, MOD1.PIN17
GP9: BOOT.2, C5.2, J4.2, MOD1.PIN2, R3.1, R3.2, U1.13
GP18: J5.8, MOD1.PIN11
GP19: J5.9, MOD1.PIN10
GPI(PIN21): J7.2, MOD2.12
GPIO(PIN12): J6.6, MOD2.5
GPIO(PIN15): J7.6, MOD2.16
GPIO(PIN16): J6.5, MOD2.6
GPIO(PIN17): J7.5, MOD2.15
GPIO(PIN18): J6.4, MOD2.7
GPIO(PIN19): J6.1, MOD2.10
GPIO(PIN20): J6.2, MOD2.9
unnamed: LED2.C, R2.2
unnamed: LED1.C, R1.2
OA0+(PIN4): J6.8, MOD2.3
OA0-(PIN3): J7.10, MOD2.20
OA0_OUT(PIN5): J7.7, MOD2.17
OA1+(PIN23): J7.3, MOD2.13
OA1-(PIN24): J6.9, MOD2.2
OA1_OUT(PIN22): J6.3, MOD2.8
RH0A(PIN6): J6.7, MOD2.4
RH1B(PIN9): J7.4, MOD2.14
RXI: J4.6, MOD1.PIN6, U1.2
SCL: J3.8, J5.1, J7.8, J8.4, MOD1.PIN18, MOD2.18
SDA: J3.9, J4.3, J7.9, J8.3, MOD1.PIN3, MOD2.19
TXO: C1.2, J4.7, MOD1.PIN7, U1.3, U1.4, U1.16
UD+: J1.D+, U1.5
UD-: J1.D-, U1.6
VBUS: C2.1, IC1.3, J1.VBUS
VCC: C3.+, IC1.2, J3.2, J4.8, J7.1, J8.2, LED1.A, MOD1.PIN8, MOD2.11
