TriEmbed/quercus/hardware/breakouts/SLG46826G-breakout.brd

## EAGLE design hardware/breakouts/SLG46826G-breakout.brd (2022-08-02)

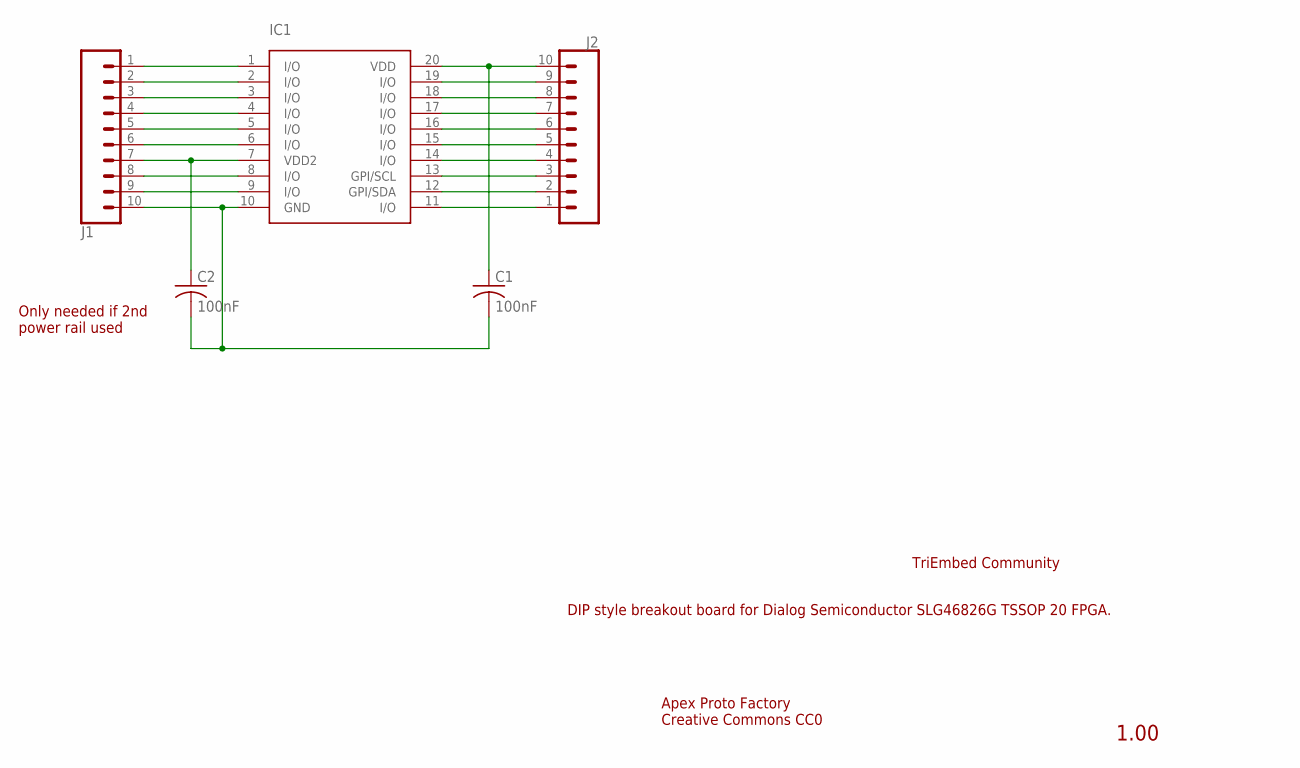
[picture p42: schematic SLG46826G-breakout.sch]

Parts:
C1, C2: 100nF; C0805
IC1: SLG46826G; TSOP-20
J1, J2: CONN_10"; 1X10

Connections:
unnamed: IC1.1 (I/O), J1.1
unnamed: IC1.11 (I/O), J2.1
unnamed: IC1.14 (I/O), J2.4
unnamed: IC1.2 (I/O), J1.2
unnamed: IC1.3 (I/O), J1.3
unnamed: IC1.4 (I/O), J1.4
unnamed: IC1.5 (I/O), J1.5
unnamed: IC1.6 (I/O), J1.6
unnamed: C2.1, IC1.7 (VDD2), J1.7
unnamed: IC1.8 (I/O), J1.8
unnamed: IC1.9 (I/O), J1.9
unnamed: C1.2, C2.2, IC1.10 (GND), J1.10
unnamed: C1.1, IC1.20 (VDD), J2.10
unnamed: IC1.19 (I/O), J2.9
unnamed: IC1.18 (I/O), J2.8
unnamed: IC1.17 (I/O), J2.7
unnamed: IC1.16 (I/O), J2.6
unnamed: IC1.15 (I/O), J2.5
unnamed: IC1.13 (GPI/SCL), J2.3
unnamed: IC1.12 (GPI/SDA), J2.2

Notes on the sheet:
Only needed if 2nd power rail used
DIP style breakout board for Dialog Semiconductor SLG46826G TSSOP 20 FPGA.
1.00
TriEmbed Community
Apex Proto Factory Creative Commons CC0

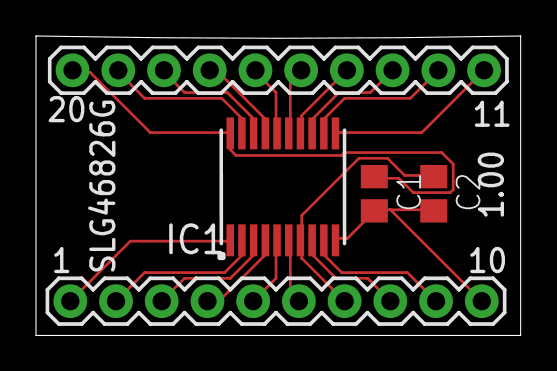
[picture p43: board SLG46826G-breakout.brd from above]

Board: 2 copper layers, 26.9 x 16.6 mm, 5 parts (0 on the bottom side), 20 nets.
