TriEmbed/quercus/hardware/purple/eagle/v0.65/m80-v0.65.brd

## EAGLE design hardware/purple/eagle/v0.65/m80-v0.65.brd (2022-08-02, an earlier design)

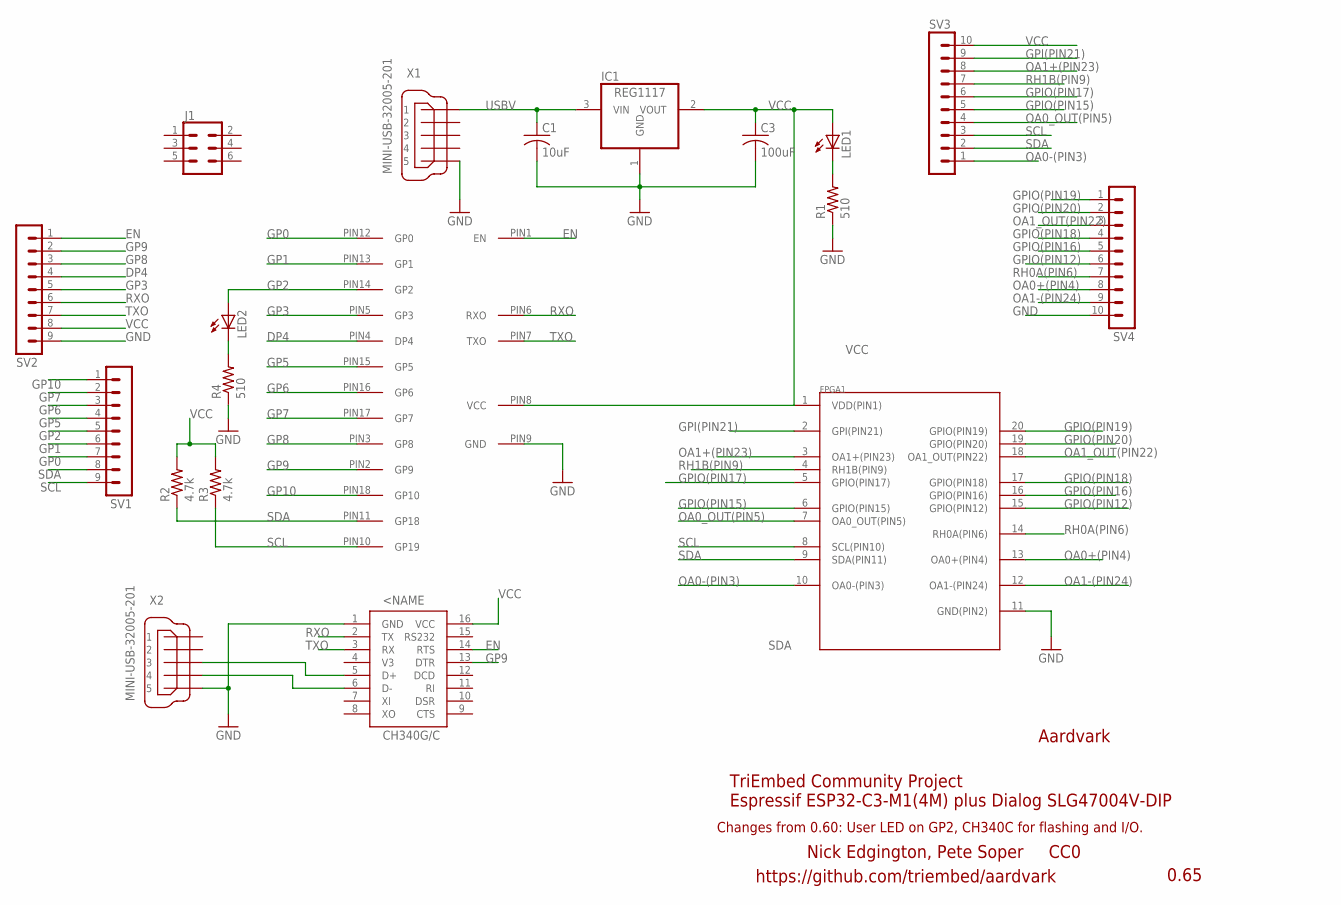
[picture p44: schematic m80-v0.65.sch]

Parts:
C1: 10uF; C0805
C3: 100uF; C1206
FPGA1: SLG7004V_DIP; SLG47004V-DIP
IC1: REG1117; SOT223
IC2: CH340G; SOIC16
J1: CONN_03X2NO_SILK; 2X3-NS
LED1, LED2: LEDCHIP-LED0805; CHIP-LED0805
R1, R4: 510; R0805
R2, R3: 4.7k; R0805
SV1, SV2: MA09-1
SV3, SV4: MA10-1
U$2: UNTITLED_ESP32C3; UNTITLED_ESP32-C3-01M
X1, X2: MINI-USB-32005-201; 32005-201

Connections:
DP4: SV2.4, U$2.PIN4 (DP4)
EN: IC2.14 (RTS), SV2.1, U$2.PIN1 (EN)
GND: C1.2, C3.2, FPGA1.11 (GND(PIN2)), IC1.1 (GND), IC2.1 (GND), R1.1, R4.1, SV2.9, SV4.10, U$2.PIN9 (GND), X1.5, X2.5
GP0: SV1.7, U$2.PIN12 (GP0)
GP1: SV1.6, U$2.PIN13 (GP1)
GP2: LED2.A, SV1.5, U$2.PIN14 (GP2)
GP3: SV2.5, U$2.PIN5 (GP3)
GP5: SV1.4, U$2.PIN15 (GP5)
GP6: SV1.3, U$2.PIN16 (GP6)
GP7: SV1.2, U$2.PIN17 (GP7)
GP8: SV2.3, U$2.PIN3 (GP8)
GP9: IC2.13 (DTR), SV2.2, U$2.PIN2 (GP9)
GP10: SV1.1, U$2.PIN18 (GP10)
GPI(PIN21): FPGA1.2 (GPI(PIN21)), SV3.9
GPIO(PIN12): FPGA1.15 (GPIO(PIN12)), SV4.6
GPIO(PIN15): FPGA1.6 (GPIO(PIN15)), SV3.5
GPIO(PIN16): FPGA1.16 (GPIO(PIN16)), SV4.5
GPIO(PIN17): FPGA1.5 (GPIO(PIN17)), SV3.6
GPIO(PIN18): FPGA1.17 (GPIO(PIN18)), SV4.4
GPIO(PIN19): FPGA1.20 (GPIO(PIN19)), SV4.1
GPIO(PIN20): FPGA1.19 (GPIO(PIN20)), SV4.2
unnamed: LED2.C, R4.2
unnamed: IC2.6 (D-), X2.4
unnamed: LED1.C, R1.2
unnamed: IC2.5 (D+), X2.3
OA0+(PIN4): FPGA1.13 (OA0+(PIN4)), SV4.8
OA0-(PIN3): FPGA1.10 (OA0-(PIN3)), SV3.1
OA0_OUT(PIN5): FPGA1.7 (OA0_OUT(PIN5)), SV3.4
OA1+(PIN23): FPGA1.3 (OA1+(PIN23)), SV3.8
OA1-(PIN24): FPGA1.12 (OA1-(PIN24)), SV4.9
OA1_OUT(PIN22): FPGA1.18 (OA1_OUT(PIN22)), SV4.3
RH0A(PIN6): FPGA1.14 (RH0A(PIN6)), SV4.7
RH1B(PIN9): FPGA1.4 (RH1B(PIN9)), SV3.7
RXO: IC2.2 (TX), SV2.6, U$2.PIN6 (RXO)
SCL: FPGA1.8 (SCL(PIN10)), R3.1, SV1.9, SV3.3, U$2.PIN10 (GP19)
SDA: FPGA1.9 (SDA(PIN11)), R2.1, SV1.8, SV3.2, U$2.PIN11 (GP18)
TXO: IC2.3 (RX), SV2.7, U$2.PIN7 (TXO)
USBV: C1.1, IC1.3 (VIN), X1.1
VCC: C3.1, FPGA1.1 (VDD(PIN1)), IC1.2 (VOUT), IC2.16 (VCC), LED1.A, R2.2, R3.2, SV2.8, SV3.10, U$2.PIN8 (VCC)

Notes on the sheet:
0.65
Aardvark
TriEmbed Community Project Espressif ESP32-C3-M1(4M) plus Dialog SLG47004V-DIP
Nick Edgington, Pete Soper CC0
https://github.com/triembed/aardvark
Changes from 0.60: User LED on GP2, CH340C for flashing and I/O.

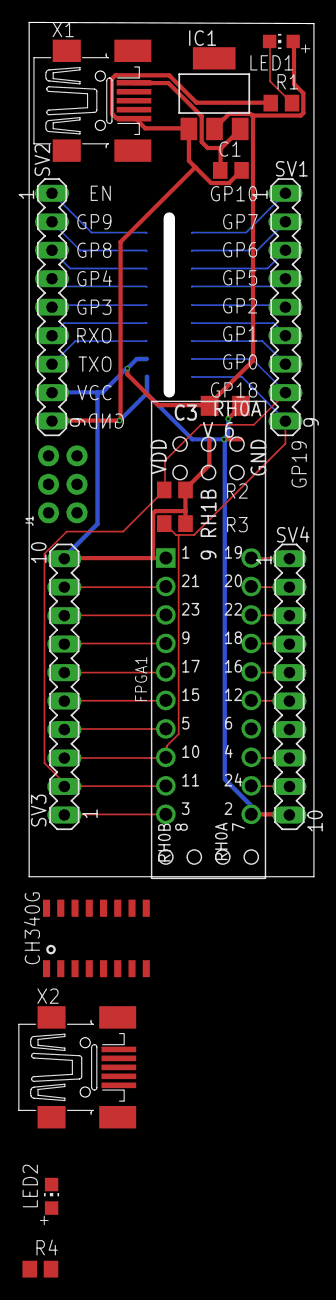
[picture p45: board m80-v0.65.brd from above]

Board: 2 copper layers, 25.4 x 76.2 mm, 19 parts (0 on the bottom side), 39 nets.
