TriEmbed/quercus/hardware/purple/eagle/v0.01/m80-v0.01.brd

## EAGLE design hardware/purple/eagle/v0.01/m80-v0.01.brd (2022-08-02, an earlier design)

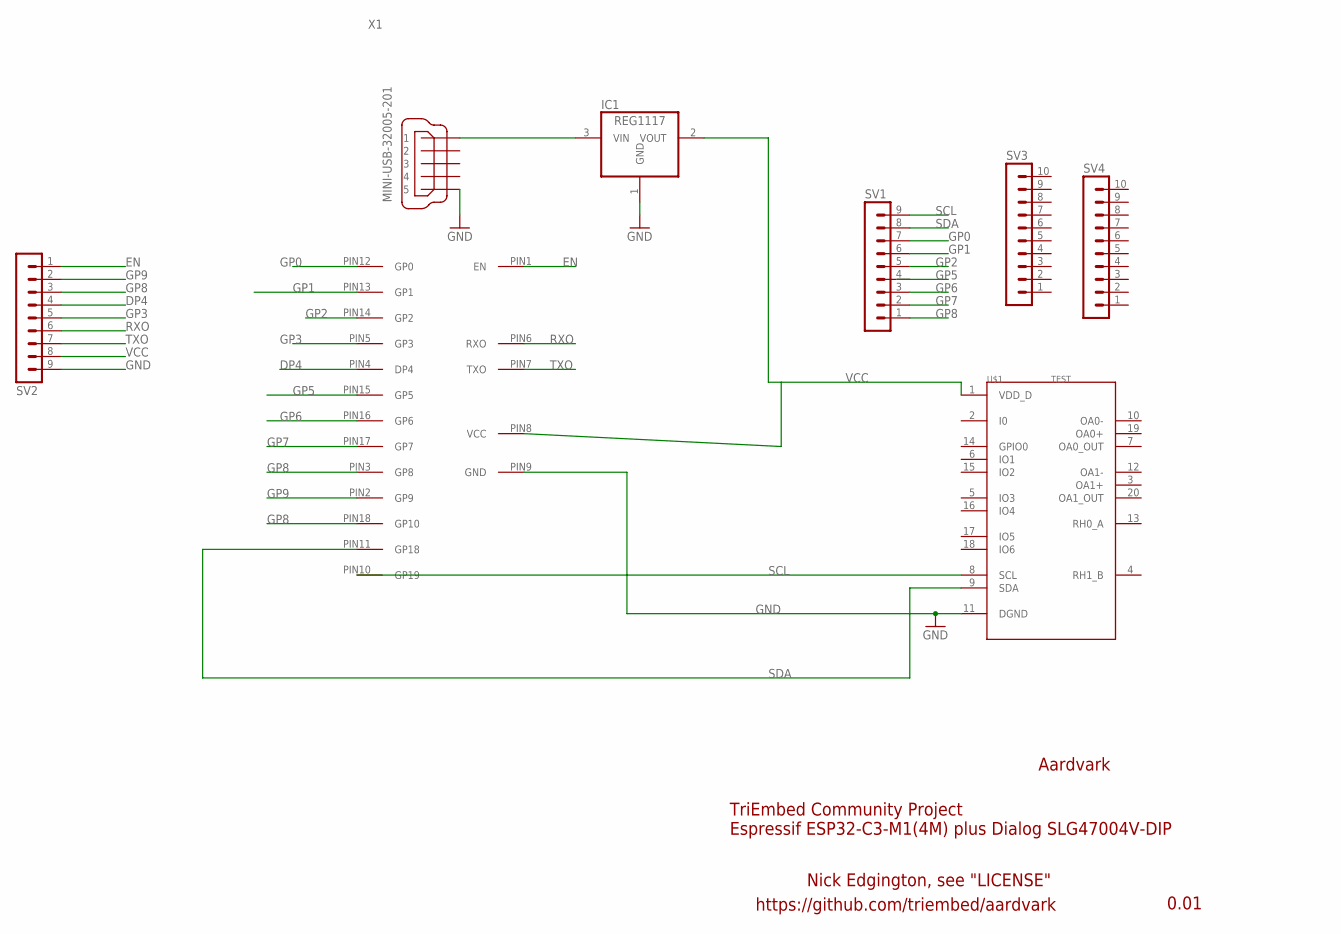
[picture p46: schematic m80-v0.01.sch]

Parts:
IC1: REG1117; SOT223
SV1, SV2: MA09-1
SV3, SV4: MA10-1
U$1: TEST; 3M_220-3342-00-0602J_0
U$2: ESP32C3; ESP32-C3-01M
X1: MINI-USB-32005-201; 32005-201

Connections:
DP4: SV2.4, U$2.PIN4 (DP4)
EN: SV2.1, U$2.PIN1 (EN)
GND: IC1.1 (GND), SV2.9, U$1.11 (DGND), U$2.PIN9 (GND), X1.5
GP0: SV1.7, U$2.PIN12 (GP0)
GP1: SV1.6, U$2.PIN13 (GP1)
GP2: SV1.5, U$2.PIN14 (GP2)
GP3: SV2.5, U$2.PIN5 (GP3)
GP5: SV1.4, U$2.PIN15 (GP5)
GP6: SV1.3, U$2.PIN16 (GP6)
GP7: SV1.2, U$2.PIN17 (GP7)
GP8: SV1.1, SV2.3, U$2.PIN3 (GP8), U$2.PIN18 (GP10)
GP9: SV2.2, U$2.PIN2 (GP9)
unnamed: IC1.3 (VIN), X1.1
RXO: SV2.6, U$2.PIN6 (RXO)
SCL: SV1.9, U$1.8 (SCL), U$2.PIN10 (GP19)
SDA: SV1.8, U$1.9 (SDA), U$2.PIN11 (GP18)
TXO: SV2.7, U$2.PIN7 (TXO)
VCC: IC1.2 (VOUT), SV2.8, U$1.1 (VDD_D), U$2.PIN8 (VCC)

Notes on the sheet:
0.01
Aardvark
TriEmbed Community Project Espressif ESP32-C3-M1(4M) plus Dialog SLG47004V-DIP
Nick Edgington, see "LICENSE"
https://github.com/triembed/aardvark

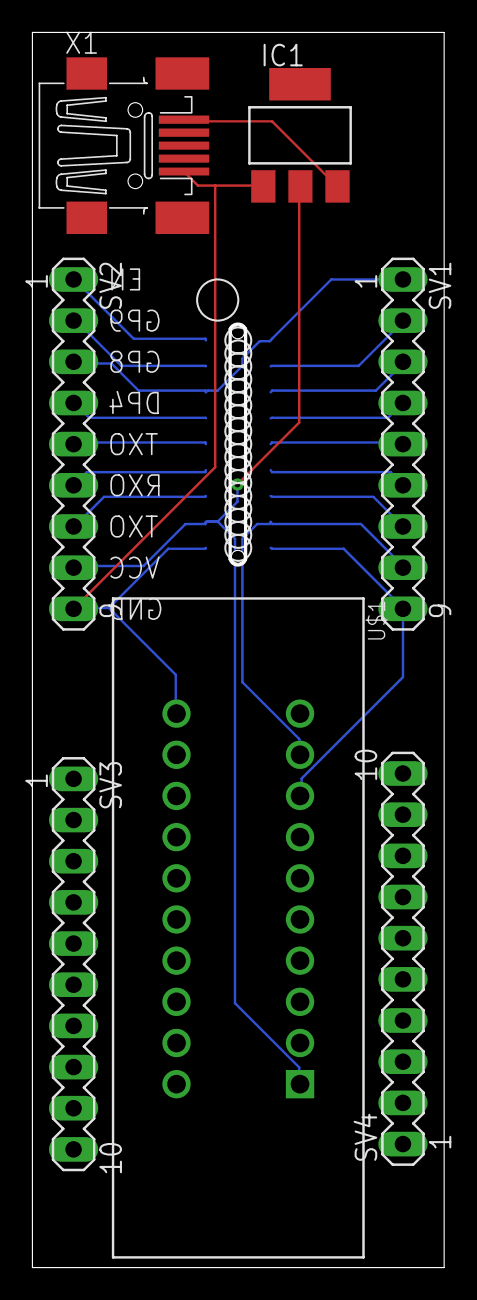
[picture p47: board m80-v0.01.brd from above]

Board: 2 copper layers, 25.4 x 76.2 mm, 8 parts (0 on the bottom side), 18 nets.
