TriEmbed/quercus/hardware/purple/eagle/v0.70/m80-v0.70.brd

## EAGLE design hardware/purple/eagle/v0.70/m80-v0.70.brd (2022-08-02, an earlier design)

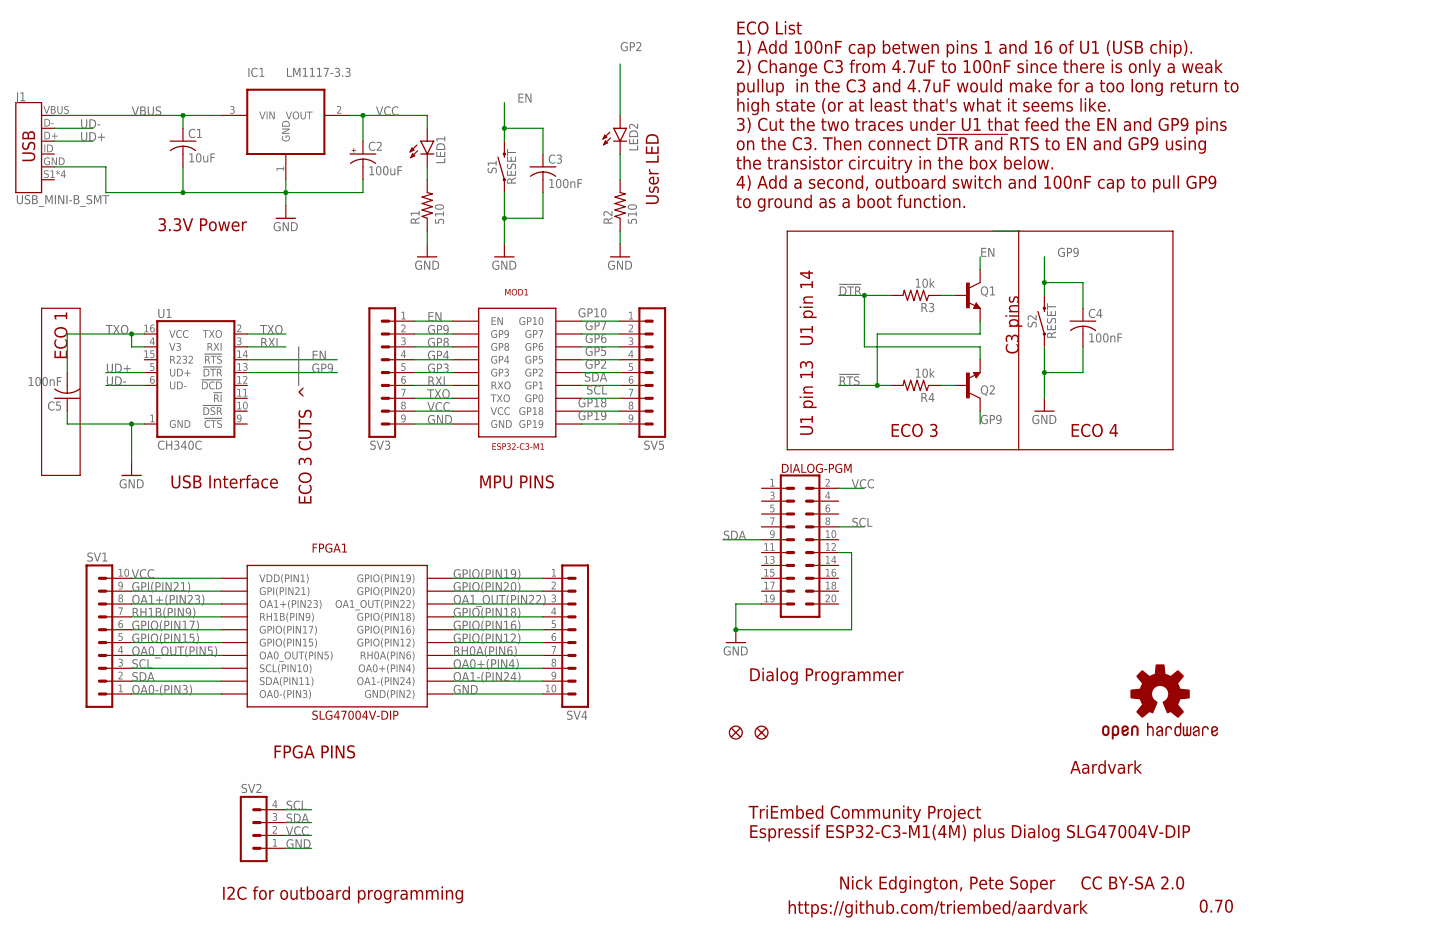
[picture p48: schematic m80-v0.70.sch]

Parts:
C1: 10uF; C0805
C2: 100uF; PANASONIC_D
C3, C4, C5: 100nF; C0805
DIALOG-PGM: CONN_10X2; 2X10
FD1, FD2: FIDUCIAL1X2; FIDUCIAL-1X2
FPGA1: SLG47004V-DIP
IC1: LM1117-3.3; SOT223
J1: USB_MINI-B_SMT; USB-MINIB
LED1, LED2: LEDCHIP-LED0805; CHIP-LED0805
LOGO1: OSHW-LOGOMINI; OSHW-LOGO-MINI
MOD1: ESP32-C3-M1; AITHINKER-C3-M1
Q1, Q2: TRANS_NPN-MMBT2222AL; SOT23-3
R1, R2: 510; R0805
R3, R4: 10k; R0805
S1, S2: RESET; TACTILE_SWITCH_SMD_6.0X3.5MM
SV1, SV4: MA10-1
SV2: MA04-1
SV3, SV5: MA09-1
U1: CH340C; SO016

Connections:
!DTR: Q2.2 (E), R3.2
!RTS: Q1.2 (E), R4.2
EN: C3.1, MOD1.PIN1 (EN), Q1.3 (C), S1.2, SV3.1, U1.14 (!RTS)
GND: C1.2, C2.-, C3.2, C4.2, C5.1, DIALOG-PGM.12, DIALOG-PGM.19, FPGA1.11 (GND(PIN2)), IC1.1 (GND), J1.GND, MOD1.PIN9 (GND), R1.1, R2.1, S1.1, S2.1, SV2.1, SV3.9, SV4.10, U1.1 (GND)
GP2: LED2.A, MOD1.PIN14 (GP2), SV5.5
GP3: MOD1.PIN5 (GP3), SV3.5
GP4: MOD1.PIN4 (GP4), SV3.4
GP5: MOD1.PIN15 (GP5), SV5.4
GP6: MOD1.PIN16 (GP6), SV5.3
GP7: MOD1.PIN17 (GP7), SV5.2
GP8: MOD1.PIN3 (GP8), SV3.3
GP9: C4.1, MOD1.PIN2 (GP9), Q2.3 (C), S2.2, SV3.2, U1.13 (!DTR)
GP10: MOD1.PIN18 (GP10), SV5.1
GP18: MOD1.PIN11 (GP18), SV5.8
GP19: MOD1.PIN10 (GP19), SV5.9
GPI(PIN21): FPGA1.2 (GPI(PIN21)), SV1.9
GPIO(PIN12): FPGA1.15 (GPIO(PIN12)), SV4.6
GPIO(PIN15): FPGA1.6 (GPIO(PIN15)), SV1.5
GPIO(PIN16): FPGA1.16 (GPIO(PIN16)), SV4.5
GPIO(PIN17): FPGA1.5 (GPIO(PIN17)), SV1.6
GPIO(PIN18): FPGA1.17 (GPIO(PIN18)), SV4.4
GPIO(PIN19): FPGA1.20 (GPIO(PIN19)), SV4.1
GPIO(PIN20): FPGA1.19 (GPIO(PIN20)), SV4.2
unnamed: LED2.C, R2.2
unnamed: LED1.C, R1.2
unnamed: Q1.1 (B), R3.1
unnamed: Q2.1 (B), R4.1
OA0+(PIN4): FPGA1.13 (OA0+(PIN4)), SV4.8
OA0-(PIN3): FPGA1.10 (OA0-(PIN3)), SV1.1
OA0_OUT(PIN5): FPGA1.7 (OA0_OUT(PIN5)), SV1.4
OA1+(PIN23): FPGA1.3 (OA1+(PIN23)), SV1.8
OA1-(PIN24): FPGA1.12 (OA1-(PIN24)), SV4.9
OA1_OUT(PIN22): FPGA1.18 (OA1_OUT(PIN22)), SV4.3
RH0A(PIN6): FPGA1.14 (RH0A(PIN6)), SV4.7
RH1B(PIN9): FPGA1.4 (RH1B(PIN9)), SV1.7
RXI: MOD1.PIN6 (RXO), SV3.6, U1.3 (RXI)
SCL: DIALOG-PGM.8, FPGA1.8 (SCL(PIN10)), MOD1.PIN12 (GP0), SV1.3, SV2.4, SV5.7
SDA: DIALOG-PGM.9, FPGA1.9 (SDA(PIN11)), MOD1.PIN13 (GP1), SV1.2, SV2.3, SV5.6
TXO: C5.2, MOD1.PIN7 (TXO), SV3.7, U1.2 (TXO), U1.4 (V3), U1.16 (VCC)
UD+: J1.D+, U1.5 (UD+)
UD-: J1.D-, U1.6 (UD-)
VBUS: C1.1, IC1.3 (VIN), J1.VBUS
VCC: C2.+, DIALOG-PGM.2, FPGA1.1 (VDD(PIN1)), IC1.2 (VOUT), LED1.A, MOD1.PIN8 (VCC), SV1.10, SV2.2, SV3.8

Notes on the sheet:
0.70
Aardvark
TriEmbed Community Project Espressif ESP32-C3-M1(4M) plus Dialog SLG47004V-DIP
Nick Edgington, Pete Soper CC BY-SA 2.0
https://github.com/triembed/aardvark
FPGA PINS
MPU PINS
USB Interface
3.3V Power
User LED
Dialog Programmer
I2C for outboard programming
ECO List 1) Add 100nF cap betwen pins 1 and 16 of U1 (USB chip). 2) Change C3 from 4.7uF to 100nF since there is only a weak pullup in the C3 and 4.7uF would make for a too long return to high state (or at least that's what it seems like. 3) Cut the two traces under U1 that feed the EN and GP9 pins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
ECO 3 CUTS ^
U1 pin 13
U1 pin 14
C3 pins
ECO 4
ECO 3
ECO 1

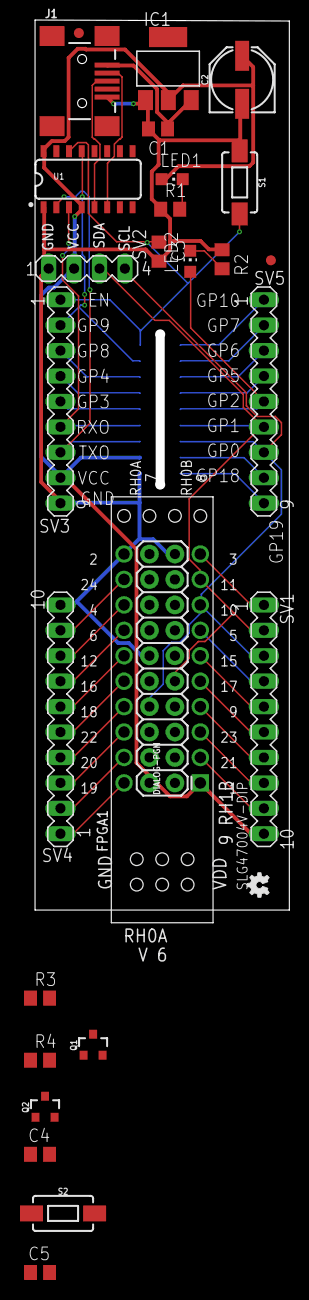
[picture p49: board m80-v0.70.brd from above]

Board: 2 copper layers, 25.4 x 88.9 mm, 29 parts (0 on the bottom side), 43 nets.
