TriEmbed/quercus/ant/main/OTAServer.h

#pragma once

#include <esp_http_server.h>

extern httpd_handle_t OTA_server;
httpd_handle_t start_OTA_webserver(void);
void stop_OTA_webserver(httpd_handle_t server);


esp_err_t OTA_update_status_handler(httpd_req_t *req);
