TriEmbed/quercus/(commit log)

2021-12-31 Added oc/contrib/dialog/cad/GREENPAK.lbr, ditched useless part
2022-01-01 SLG46826G Breakout version 1.00
    [SLG46826G-breakout.brd, SLG46826G-breakout.sch]
2022-01-01 dialog/SLG46826G-breakout version 1.00
    [SLG46826G-breakout.brd, SLG46826G-breakout.sch]
2022-01-08 rename SLG46826G breakout directory
    [SLG46826G-breakout.brd, SLG46826G-breakout.sch]
2022-01-08 README.md for initial Dialog breakout board
2022-01-08 rename breakout dir
    [SLG46826G-breakout.brd, SLG46826G-breakout.sch]
2022-01-19 eagle dir with versions 0.01, 0.50 and 0.60 aardvark CAD files
    [aardvark-v0.01.brd, aardvark-v0.01.sch, aardvark-v0.50.brd, aardvark-v0.50.sch, aardvark-v0.60.brd, aardvark-v0.60.sch]
2022-01-23 hardware/wemos/images pics of cheap wrover board
2022-01-26 comment out board images 'cause they show Dialog plugged in backwards
2022-01-28 added doc/README.md hyperlinks to ESP32 boot process details and little C3 dev board being used as a model implementation
2022-01-30 eagle/v0.70 initial
    [aardvark-v0.70.brd, aardvark-v0.70.sch]
2022-01-30 eagle/v0.70 schematic and layout PDFs
2022-01-31 fixed spelling error and mirror image GND designator
    [aardvark-v0.70.brd]
2022-01-31 add OSH Park renderings of PCB top and bottom to eagle/v0.60
2022-02-01 Added todo for using different C3 pins for I2C to free up USB subsystem
2022-02-02 added todo for adding a Dialog QFN socket/programmer footprint
2022-02-02 schematic update
    [aardvark-v0.70.sch]
2022-02-02 board update: incomplete placement and routing
    [aardvark-v0.70.brd]
2022-02-02 PDF of schematic
2022-02-02 new convension for PDFs foo-board.pdf instead of -layout.pdf
2022-02-02 Fix C3 module footprint, shift pin outside SLG footprint, update notes
    [aardvark-v0.70.brd, aardvark-v0.70.sch]
2022-02-02 really fix slot width
2022-02-02 swap C3 board in that really has slot narrowed
    [aardvark-v0.70.brd, aardvark-v0.70.sch]
2022-02-02 added right angle header site for outboard I2C programming
    [aardvark-v0.70.brd, aardvark-v0.70.sch]
2022-02-03 rev 0.65 reflecting current 0.60 + breadboard circuits
    [aardvark-v0.65.brd, aardvark-v0.65.sch]
2022-02-03 Noted shortening/narrowing of slot for C3
2022-02-03 confirmed Dialog programming socket board will not physically interfere
2022-02-04 0.70 release candidate
    [aardvark-v0.70.brd, aardvark-v0.70.sch]
2022-02-04 aardvark v0.70 as shipped to OSH Park
    [aardvark-v0.70.brd, aardvark-v0.70.sch]
2022-02-05 added eagle/v0.70/BOM.ods
    [BOM.ods]
2022-02-06 initial DRAFT v0.80 files
    [aardvark-v0.80.brd, aardvark-v0.80.sch]
2022-02-08 images/model-esp32-board.jpg has reset/boot circuit needed on our boards
2022-02-09 updated v0.80 w reset, boot, second schematic sheet
    [aardvark-v0.80.brd, aardvark-v0.80.sch]
2022-02-11 ECOs added to eagle/v0.70/aardvark-v0.70-schematic.pdf
2022-02-11 example usage of v0.80 shown with aardvark-v0.80-board.pdf
    [aardvark-v0.80.brd]
2022-02-14 proper momentary and power switches for v0.80
    [aardvark-v0.80.brd, aardvark-v0.80.sch]
2022-02-16 Finished initial ECOs for 0.70 board
    [aardvark-v0.70.brd, aardvark-v0.70.sch]
2022-03-30 echidna concept2
    [aardvark-v0.80.brd, aardvark-v0.80.sch, echidna-v0.81.brd, echidna-v0.81.sch]
2022-04-05 added Espressif datasheet local copy and URL
    [echidna-v0.81.brd, echidna-v0.81.sch]
2022-04-08 eagle/v0.80 0.80 board revision
    [aardvark-v0.80.brd, aardvark-v0.80.sch]
2022-04-08 eagle/v0.80 updated schematic todo list
    [aardvark-v0.80.sch]
2022-04-29 eagle/lib/{CK-ATS2D1G_NC_LFS.lbr,CK_JS202011SCQN.lbr} candidate switches
2022-05-12 eagle/v0.80/{*.brd,sch} added part numbers
    [aardvark-v0.80.brd, aardvark-v0.80.sch]
2022-05-23 fix pin connection mistake
    [aardvark-v0.80.sch]
2022-05-30 name change to 'M80', corrections, pruned mboard
    [aardvark-v0.80.brd, aardvark-v0.80.sch, echidna-v0.81.brd, echidna-v0.81.sch]
2022-06-06 added CAD and CAD/README.md and CAD/greenpack-test1.aap
2022-06-25 update notes, switch handler, finish more work on cleanit: untested
2022-06-27 main/i2c.h externs
2022-06-28 Fix web deploy to use SPI nor
2022-06-29 linux/installit 0.16 filled in a lot of needed functionality to edit the-ant config files according to chip type and other factors, require local router SSID and password, C3 M80 version x 100 (i.e. 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
2022-06-30 updated README.md with homebrew dev board instructions and instructions for connecting a Dialog SLG47004V-DIP for the blinky application
2022-07-04 sdkconfig sync with current menuconfig state
2022-07-04 linux/installit 0.24 mdns support (not yet working), always clone aardvark and the-ant 'cause too hard to track their mutations by the script, don't depend on matching Nick router labels, tidy up
2022-07-04 main/i2c.c remove blasted pin assignments again
2022-07-04 linux/installit fixed bug with unknown option switch names causing a message about the switch argument vs the (unknown) switch name
2022-07-05 fix specific MAC addr fetched in mdns initialization
    [ant_main.c]
2022-07-07 switch to que_ prefixes for project component names
2022-07-07 hardware/greenpak/README.md to doc the breakout board and point to other hardware work
2022-07-07 added prettyprinters dir to hold scripts, currently one for C/C++/C#/Object C and Java
2022-07-07 main/ant_main.c comment out mdns refs while Espressif esp-idf repo is broken
    [ant_main.c]
2022-07-08 Populated with files that had been in League and m80 repos
    [SLG46826G-breakout.brd, SLG46826G-breakout.sch]
2022-07-08 renames and refinements
    [SLG46826G-breakout.brd, SLG46826G-breakout.sch, m80-v0.01.brd, m80-v0.01.sch, m80-v0.50.brd, m80-v0.50.sch, m80-v0.60.brd, m80-v0.60.sch]
2022-07-12 linux/installit 0.29 source .bashrc in case direnv installed
2022-07-12 restore missing CAD subdir
2022-07-13 added CAD/BLINKY.app as symlink to greekpak.test1.aap
2022-07-22 filled in some mpn in BOM.ods
    [BOM.ods]
2022-08-02 push files down to ant
    [partitions_example.csv]
2022-08-02 push files down to breakouts
    [SLG46826G-breakout.brd, SLG46826G-breakout.sch]
2022-08-02 push files down to purple
    [BOM.ods, m80-v0.01.brd, m80-v0.01.sch, m80-v0.50.brd, m80-v0.50.sch, m80-v0.60.brd, m80-v0.60.sch, m80-v0.65.brd]
2022-08-03 push individual hardware projects under hardware
    [BOM.ods, SLG46826G-breakout.brd, SLG46826G-breakout.sch, m80-v0.01.brd, m80-v0.01.sch, m80-v0.50.brd, m80-v0.50.sch, m80-v0.60.brd]
2022-08-20 Issue #29 for white board doc
2022-08-20 issue #29 fixed pinout, added board pic
2022-08-27 Update config.yml
    #37 marked current links clearly as PLACEHOLDER EXAMPLE
2022-08-30 issue #29 more details for white board
2022-09-12 #45 next purple will have a DBUS connector
2022-09-12 #46 5v rail and 8chan i2c ok lvl shftr
2022-09-12 #47 hardware/purple/eagle/v1.00/\*
    [purple-v0.80.brd, purple-v0.80.sch]
2022-10-06 #50 1.00 purple requirements MOVED + FPGA for 3.3v
    Requirements moved from hardware/README.md to hardware/purple/README.md.
    Also, added FPGA-implemented switching regulator and described either/or or pick one strategies to preserve big rule for supporting hand-soldering.
